AutodriveAI/Autonomous-Mobile-Robot-/Robot Design Files/GamePadDongleHolder.stl

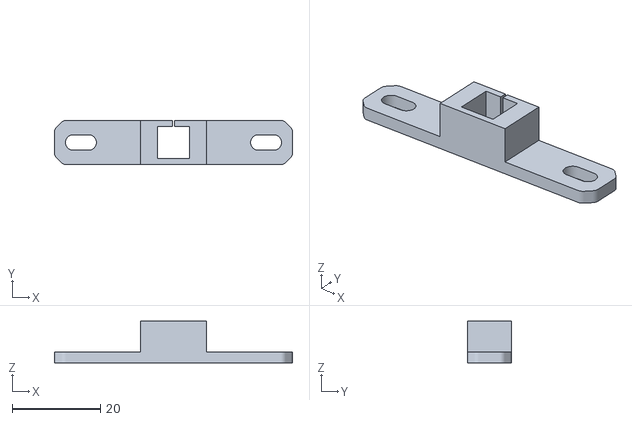
[picture p1: CAD file, 2026-10-15]
Robot Design Files/GamePadDongleHolder.stl
54.0 x 10.0 x 9.50
