AutodriveAI/Autonomous-Mobile-Robot-/ros2_ws/src/amr_description/meshes/Gear_Motor__1__Cut_Extrude8_1_.obj

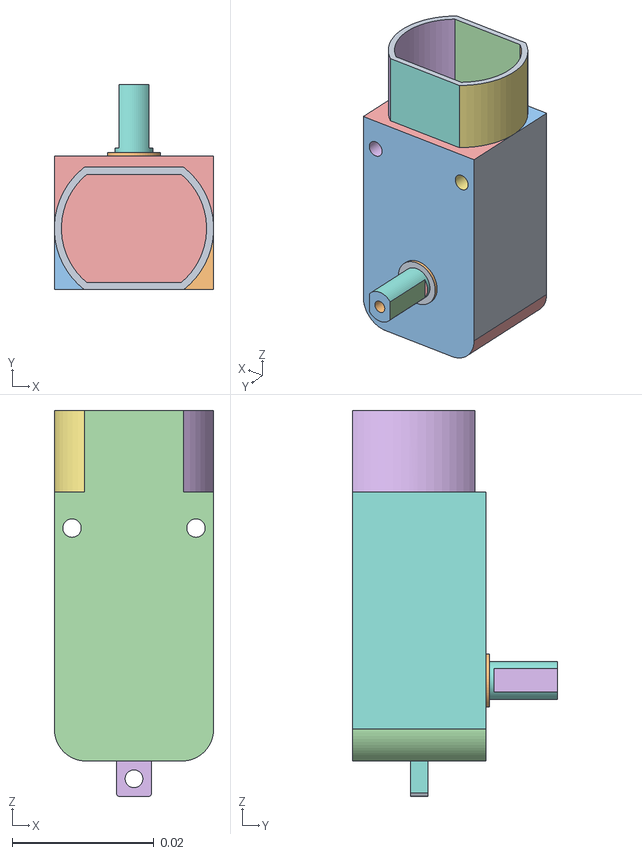
[picture p2: CAD file, 2026-07-27]
ros2_ws/src/amr_description/meshes/Gear_Motor__1__Cut_Extrude8_1_.obj
0.0225 x 0.029 x 0.0545
