AutodriveAI/Autonomous-Mobile-Robot-/Robot Design Files/antenna mount.stl

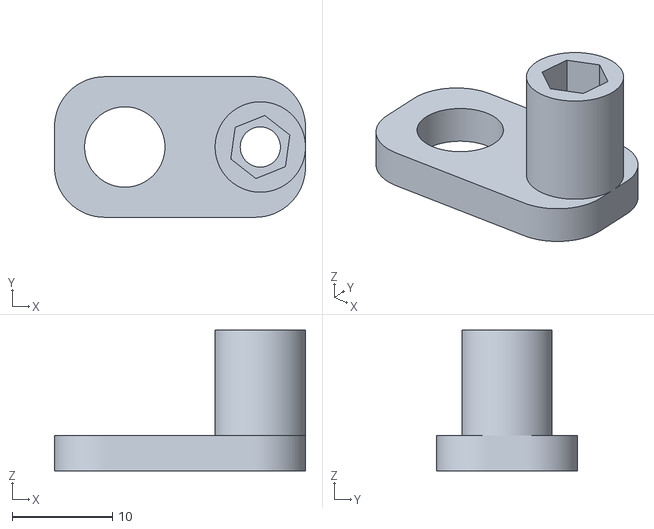
[picture p3: CAD file, 2026-08-02]
Robot Design Files/antenna mount.stl
25.0 x 14.0 x 14.0
