AutodriveAI/Autonomous-Mobile-Robot-/Robot Design Files/Hex Spacer.step

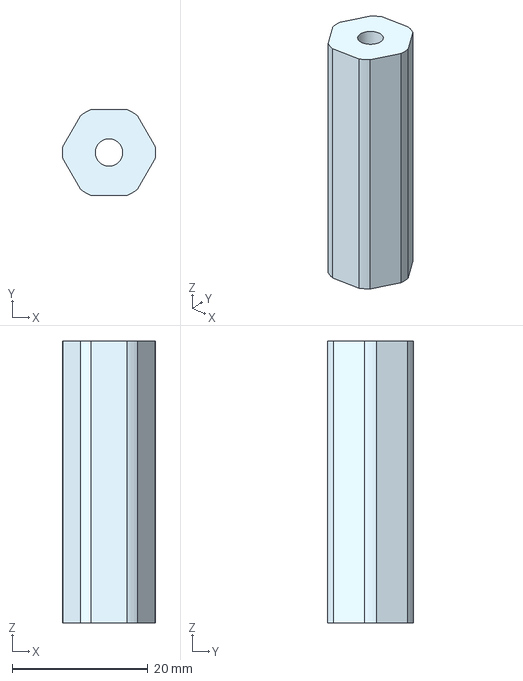
[picture p5: CAD file, 2026-08-02]
Robot Design Files/Hex Spacer.step
13.7 x 12.7 x 41.6 mm
