AutodriveAI/Autonomous-Mobile-Robot-/Robot Design Files/WiFi Antenna.STEP

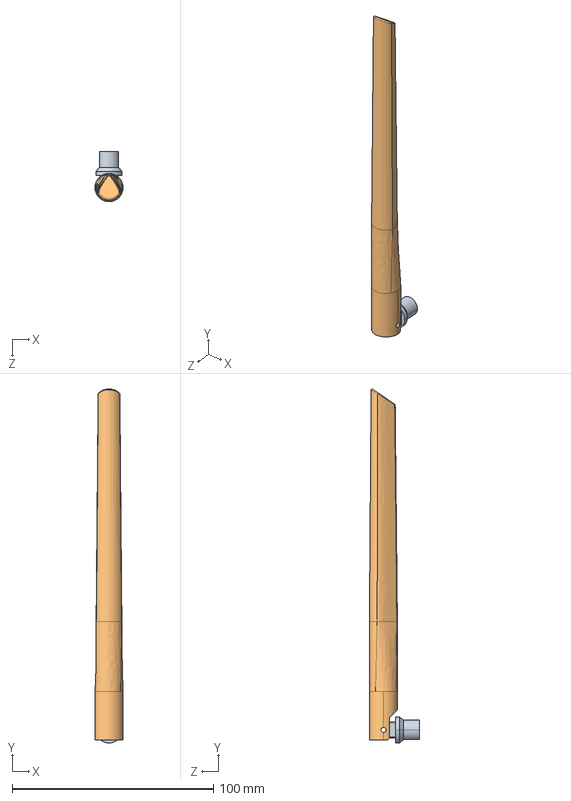
[picture p7: CAD file, 2026-08-02]
Robot Design Files/WiFi Antenna.STEP
14.0 x 176.1 x 25.1 mm
WiFi Antenna 2
WiFi Antenna
