AutodriveAI/Autonomous-Mobile-Robot-/ros2_ws/src/amr_description/meshes/Jetson_1__Body1_1_.obj

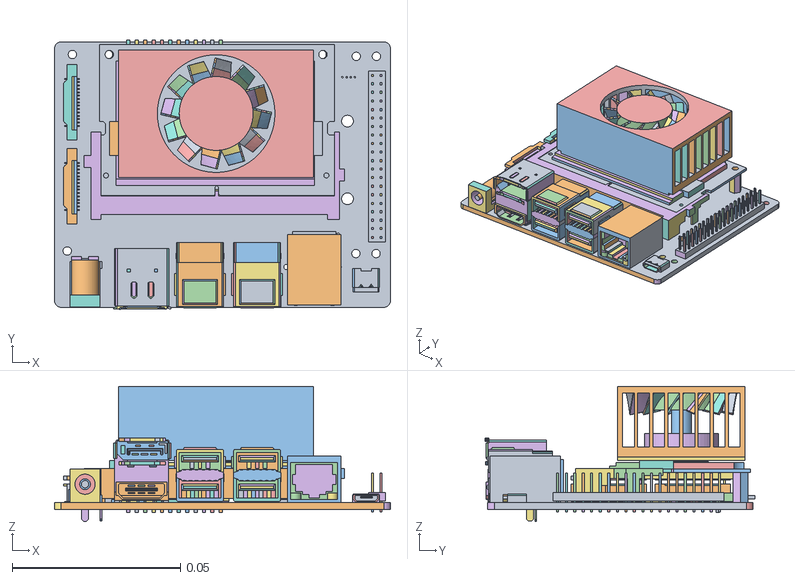
[picture p8: CAD file, 2026-07-27]
ros2_ws/src/amr_description/meshes/Jetson_1__Body1_1_.obj
0.1 x 0.0802 x 0.0402
