AutodriveAI/Autonomous-Mobile-Robot-/Robot Design Files/65mmPillar.STL

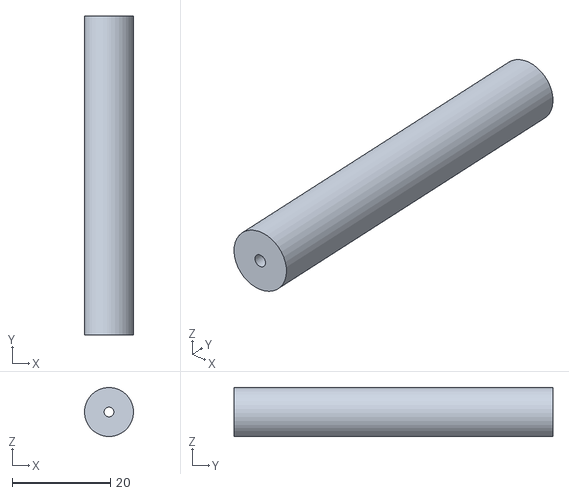
[picture p9: CAD file, 2026-07-25]
Robot Design Files/65mmPillar.STL
9.99 x 65.0 x 10.0
