AutodriveAI/Autonomous-Mobile-Robot-/ros2_ws/src/amr_description/meshes/Default__12_STEP_1_Part22_STEP_1_solid1.obj

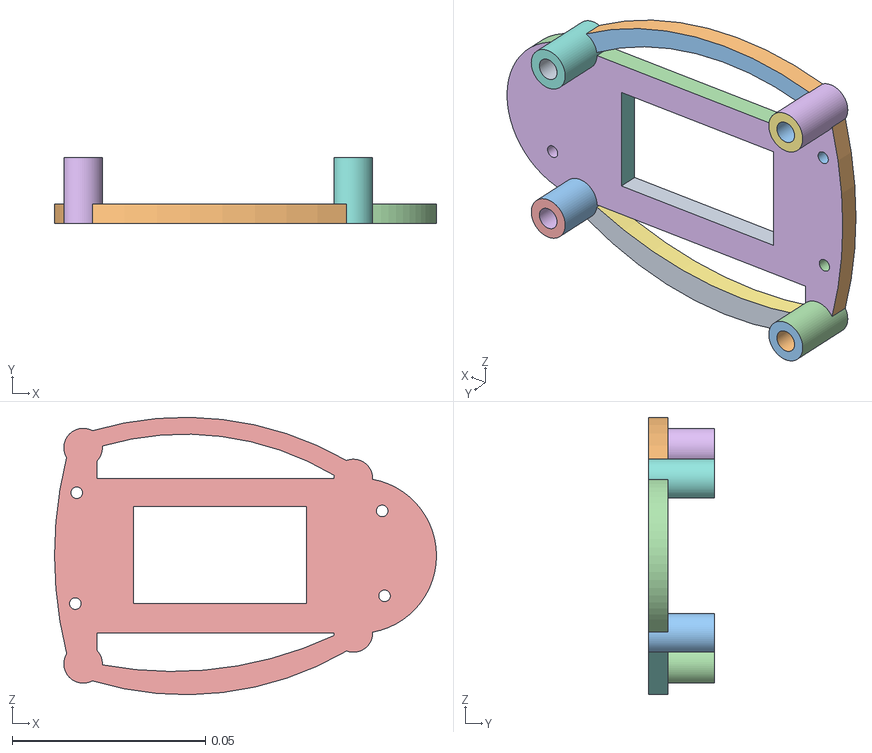
[picture p11: CAD file, 2026-07-27]
ros2_ws/src/amr_description/meshes/Default__12_STEP_1_Part22_STEP_1_solid1.obj
0.0989 x 0.017 x 0.0718
