AutodriveAI/Autonomous-Mobile-Robot-/ros2_ws/src/amr_description/meshes/Default__12_STEP_1_RP_lidar_A1_igs_STEP_1_head_base_igs_STEP_1_solid1.obj

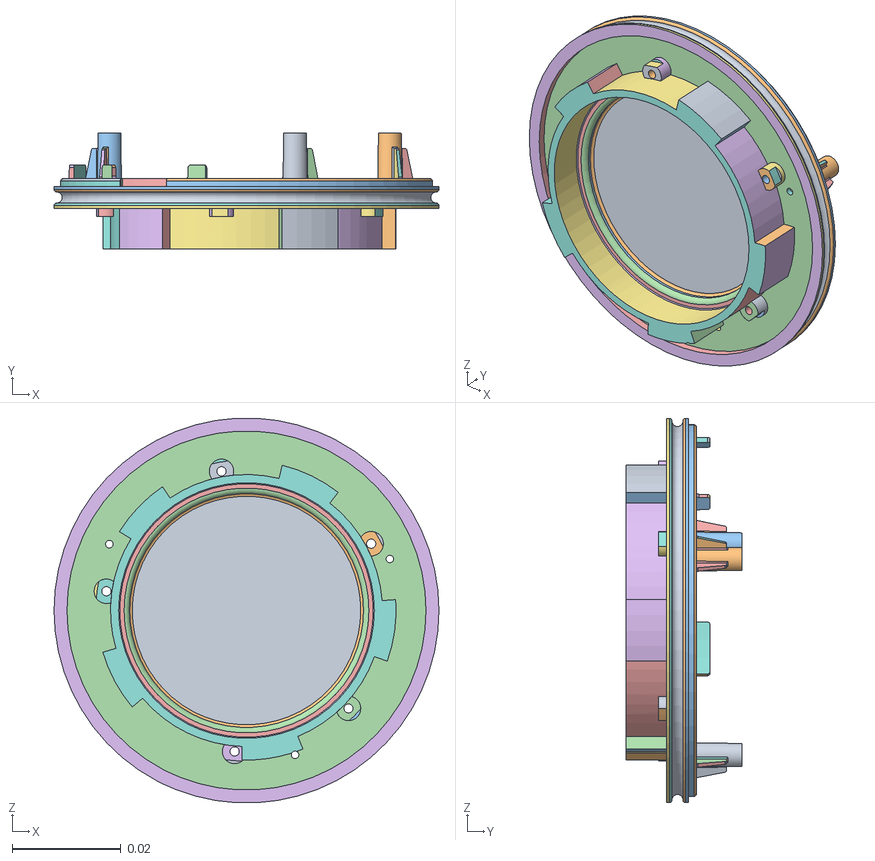
[picture p12: CAD file, 2026-07-27]
ros2_ws/src/amr_description/meshes/Default__12_STEP_1_RP_lidar_A1_igs_STEP_1_head_base_igs_STEP_1_solid1.obj
0.0708 x 0.0214 x 0.0707
