AutodriveAI/Autonomous-Mobile-Robot-/ros2_ws/src/amr_description/meshes/Default__12_STEP_1_RP_lidar_A1_igs_STEP_1_bottom_lid_igs_STEP_1_solid1.obj

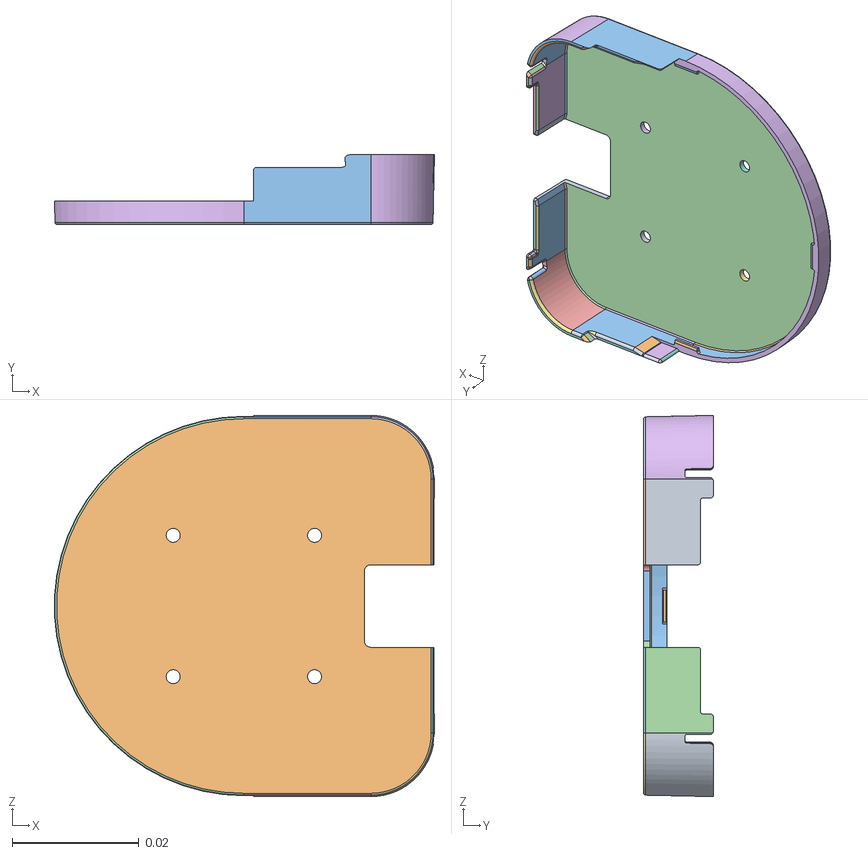
[picture p13: CAD file, 2026-07-27]
ros2_ws/src/amr_description/meshes/Default__12_STEP_1_RP_lidar_A1_igs_STEP_1_bottom_lid_igs_STEP_1_solid1.obj
0.0599 x 0.011 x 0.0601
