AutodriveAI/Autonomous-Mobile-Robot-/ros2_ws/src/amr_description/meshes/Default__12_STEP_1_RP_lidar_A1_igs_STEP_1_stand_8x2_igs_STEP_2_solid1.obj

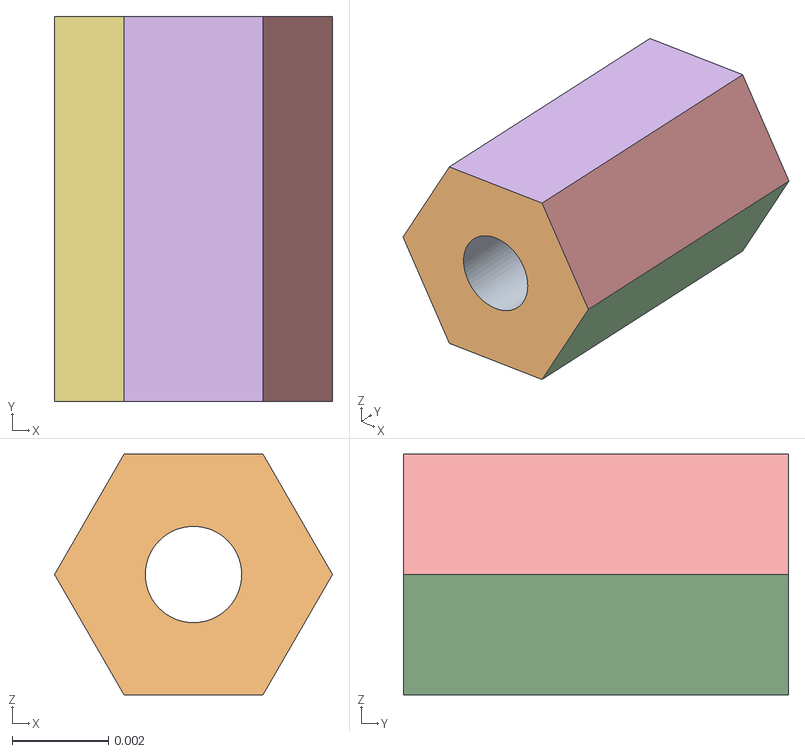
[picture p14: CAD file, 2026-07-27]
ros2_ws/src/amr_description/meshes/Default__12_STEP_1_RP_lidar_A1_igs_STEP_1_stand_8x2_igs_STEP_2_solid1.obj
0.00577 x 0.008 x 0.005
