AutodriveAI/Autonomous-Mobile-Robot-/ros2_ws/src/amr_description/meshes/Default__12_STEP_1_RP_lidar_A1_igs_STEP_1_stand_15x2_igs_STEP_4_solid1.obj

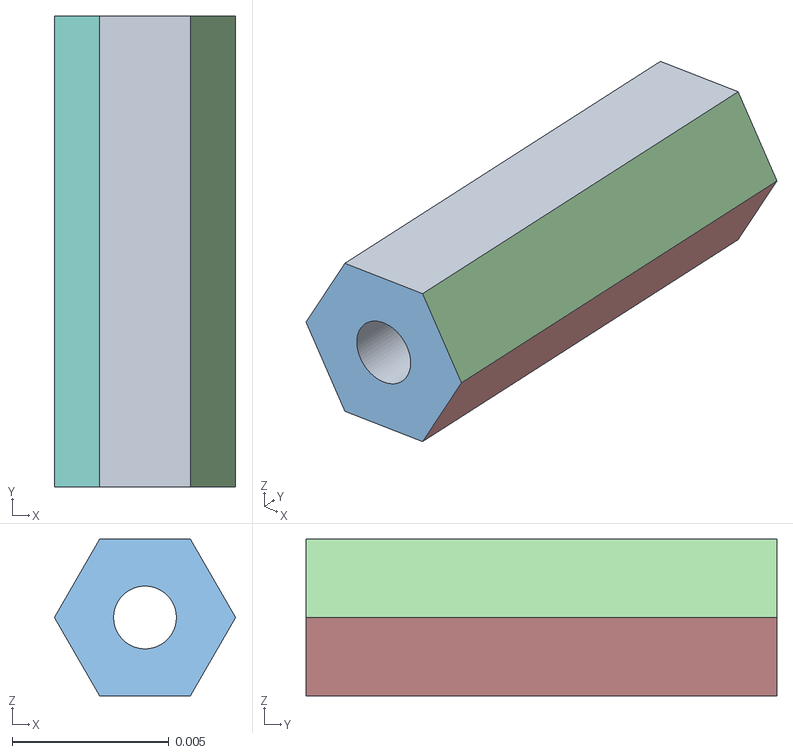
[picture p16: CAD file, 2026-07-27]
ros2_ws/src/amr_description/meshes/Default__12_STEP_1_RP_lidar_A1_igs_STEP_1_stand_15x2_igs_STEP_4_solid1.obj
0.00577 x 0.015 x 0.005
