AutodriveAI/Autonomous-Mobile-Robot-/ros2_ws/src/amr_description/meshes/Default__Ball_Caster_12mm_stp_1___03_________stp_1_solid1.obj

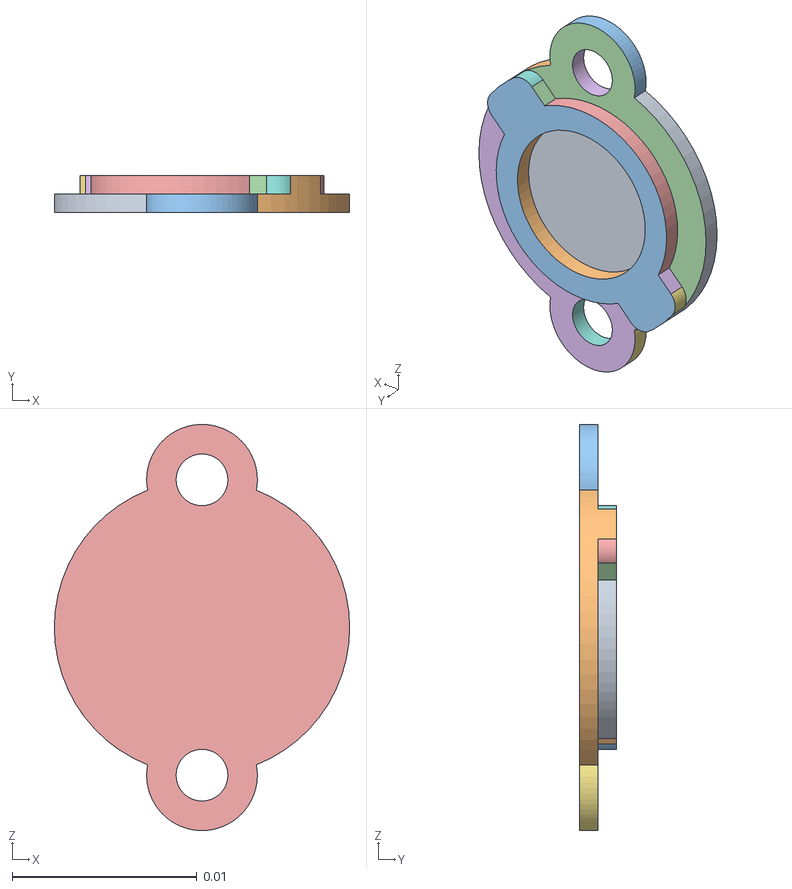
[picture p17: CAD file, 2026-07-27]
ros2_ws/src/amr_description/meshes/Default__Ball_Caster_12mm_stp_1___03_________stp_1_solid1.obj
0.016 x 0.002 x 0.022
