AutodriveAI/Autonomous-Mobile-Robot-/ros2_ws/src/amr_description/meshes/Default__Ball_Caster_12mm_stp_1___01_______12_stp_1_solid1.obj

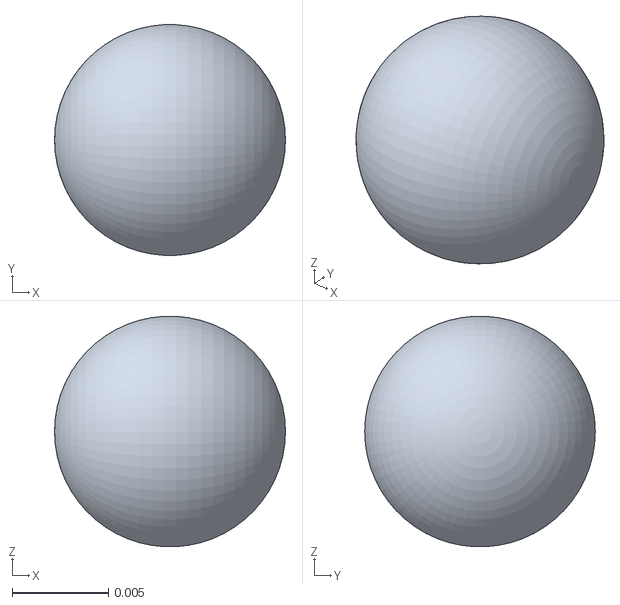
[picture p18: CAD file, 2026-07-27]
ros2_ws/src/amr_description/meshes/Default__Ball_Caster_12mm_stp_1___01_______12_stp_1_solid1.obj
0.012 x 0.012 x 0.012
