AutodriveAI/Autonomous-Mobile-Robot-/ros2_ws/src/amr_description/meshes/Part_1_2.obj

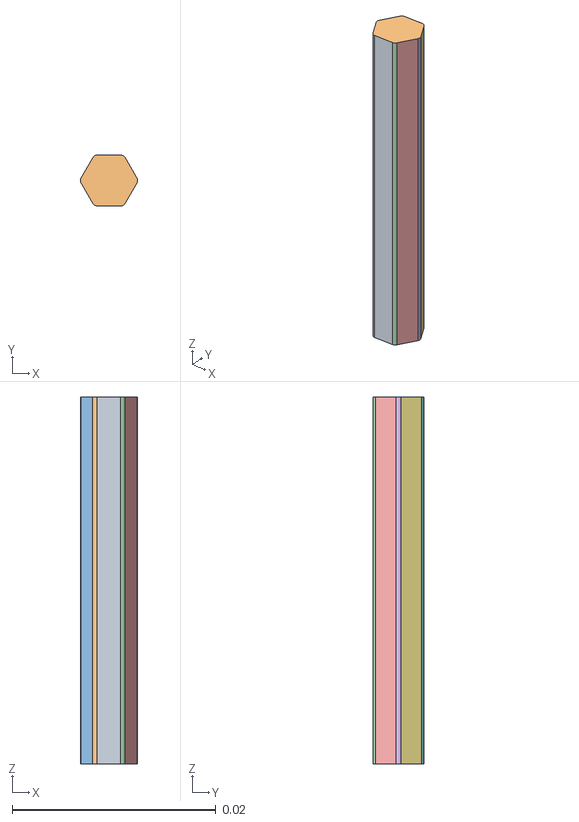
[picture p19: CAD file, 2026-07-27]
ros2_ws/src/amr_description/meshes/Part_1_2.obj
0.00562 x 0.00501 x 0.036
