AutodriveAI/Autonomous-Mobile-Robot-/ros2_ws/src/amr_description/meshes/Default__12_STEP_1_RP_lidar_A1_igs_STEP_1_laser_igs_STEP_1_solid1.obj

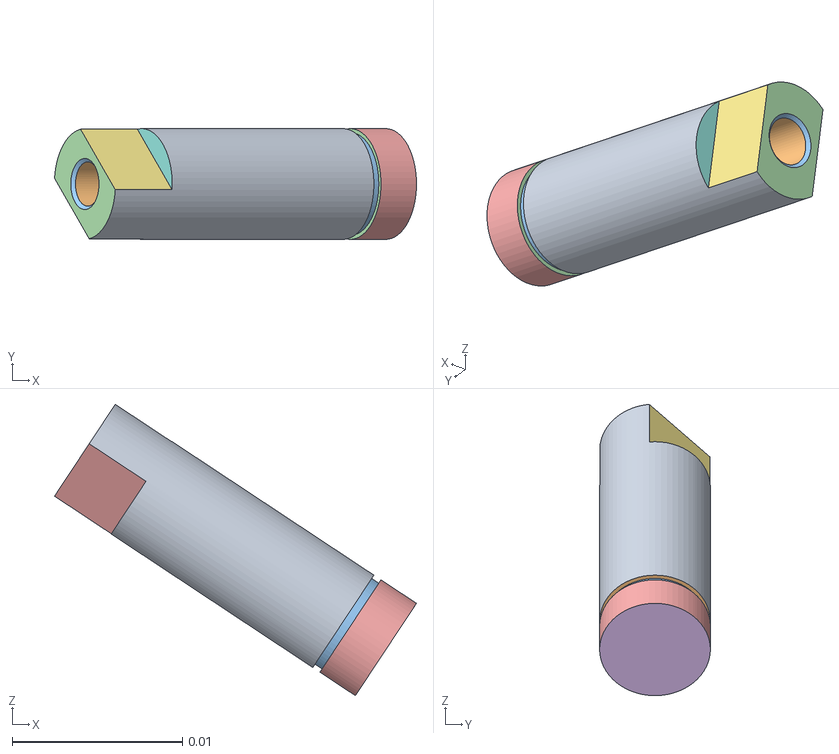
[picture p20: CAD file, 2026-07-27]
ros2_ws/src/amr_description/meshes/Default__12_STEP_1_RP_lidar_A1_igs_STEP_1_laser_igs_STEP_1_solid1.obj
0.0213 x 0.00649 x 0.0171
