AutodriveAI/Autonomous-Mobile-Robot-/ros2_ws/src/amr_description/meshes/Gear_Motor__1__Split1_2__1_.obj

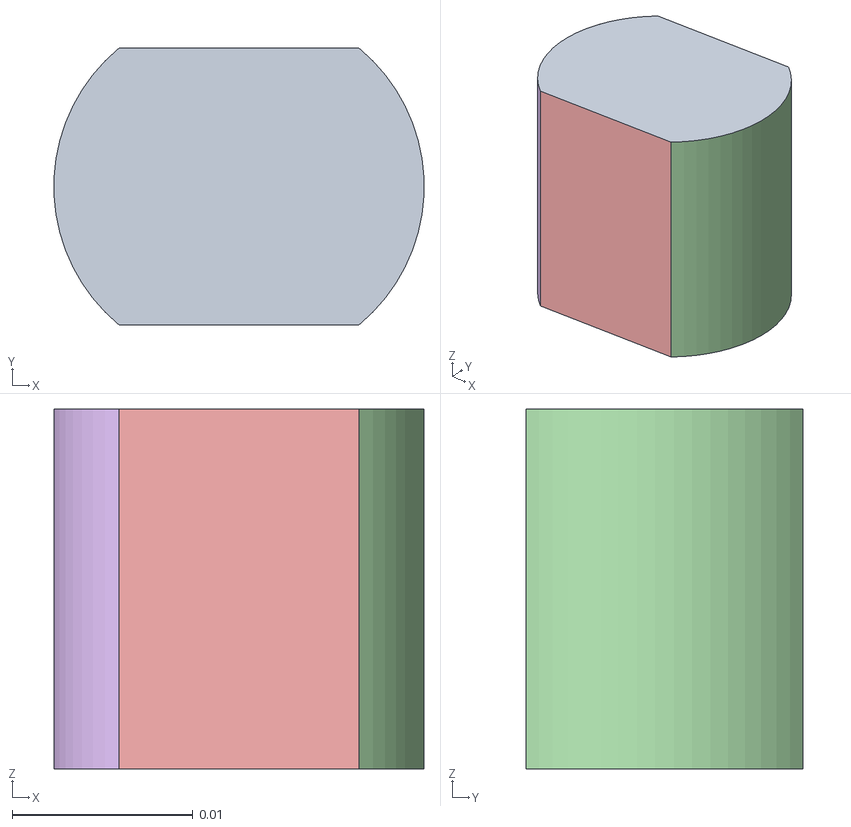
[picture p21: CAD file, 2026-07-27]
ros2_ws/src/amr_description/meshes/Gear_Motor__1__Split1_2__1_.obj
0.0205 x 0.0153 x 0.0199
