AutodriveAI/Autonomous-Mobile-Robot-/ros2_ws/src/amr_description/meshes/Default__12_STEP_1_RP_lidar_A1_igs_STEP_1_base_igs_STEP_1_solid1.obj

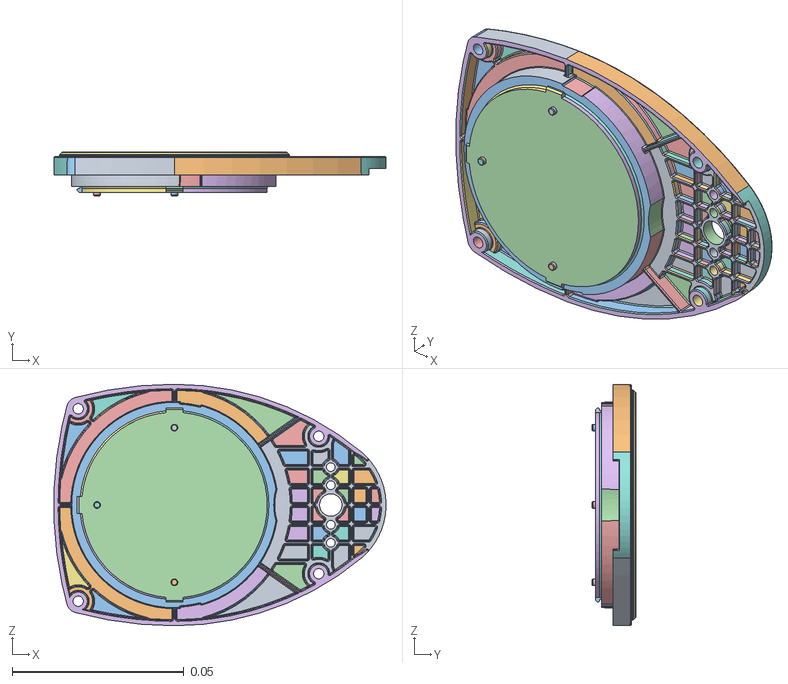
[picture p22: CAD file, 2026-07-27]
ros2_ws/src/amr_description/meshes/Default__12_STEP_1_RP_lidar_A1_igs_STEP_1_base_igs_STEP_1_solid1.obj
0.0966 x 0.0127 x 0.0703
