AutodriveAI/Autonomous-Mobile-Robot-/ros2_ws/src/amr_description/meshes/Default__Ball_Caster_12mm_stp_1___02_______4_stp_4_solid1.obj

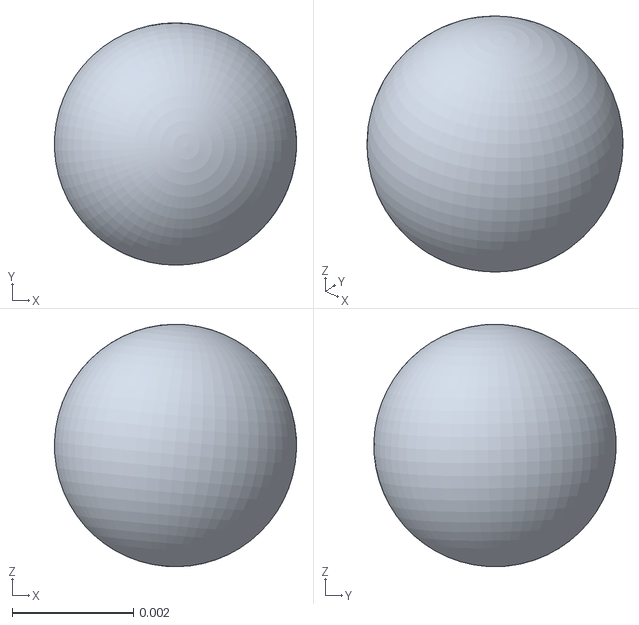
[picture p23: CAD file, 2026-07-27]
ros2_ws/src/amr_description/meshes/Default__Ball_Caster_12mm_stp_1___02_______4_stp_4_solid1.obj
0.00399 x 0.004 x 0.004
