AutodriveAI/Autonomous-Mobile-Robot-/ros2_ws/src/amr_description/meshes/motor_stand___1.obj

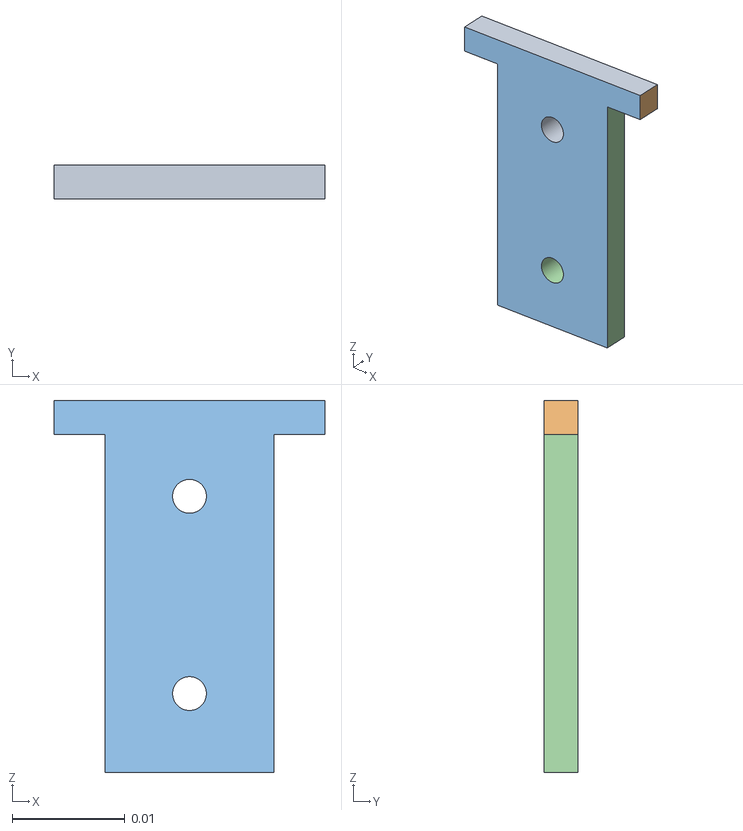
[picture p25: CAD file, 2026-07-27]
ros2_ws/src/amr_description/meshes/motor_stand___1.obj
0.024 x 0.003 x 0.033
