AutodriveAI/Autonomous-Mobile-Robot-/ros2_ws/src/amr_description/meshes/WiFi_Antenna_2__Cut_Extrude1.obj

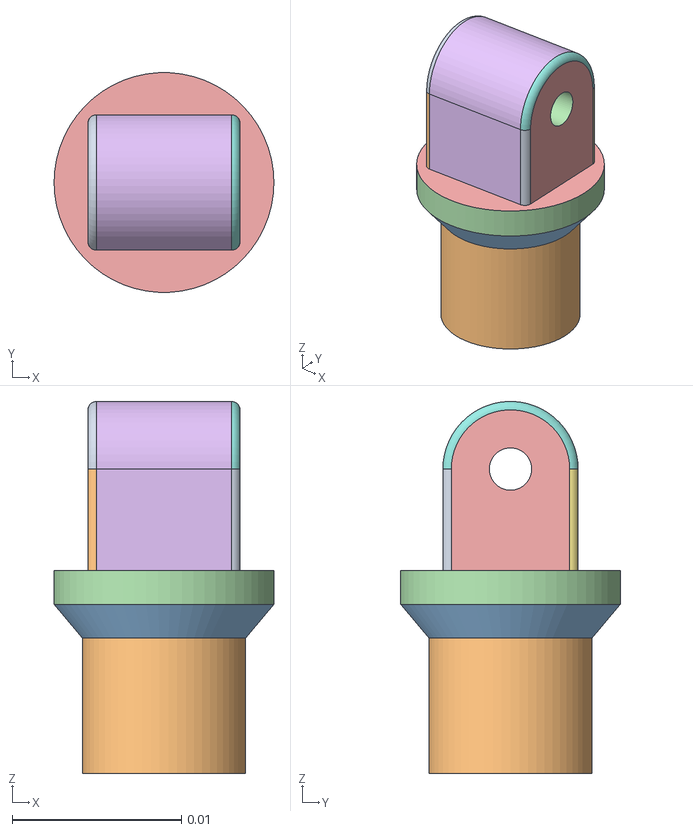
[picture p26: CAD file, 2026-07-27]
ros2_ws/src/amr_description/meshes/WiFi_Antenna_2__Cut_Extrude1.obj
0.013 x 0.013 x 0.022
