AutodriveAI/Autonomous-Mobile-Robot-/ros2_ws/src/amr_description/meshes/mid_floor_1.obj

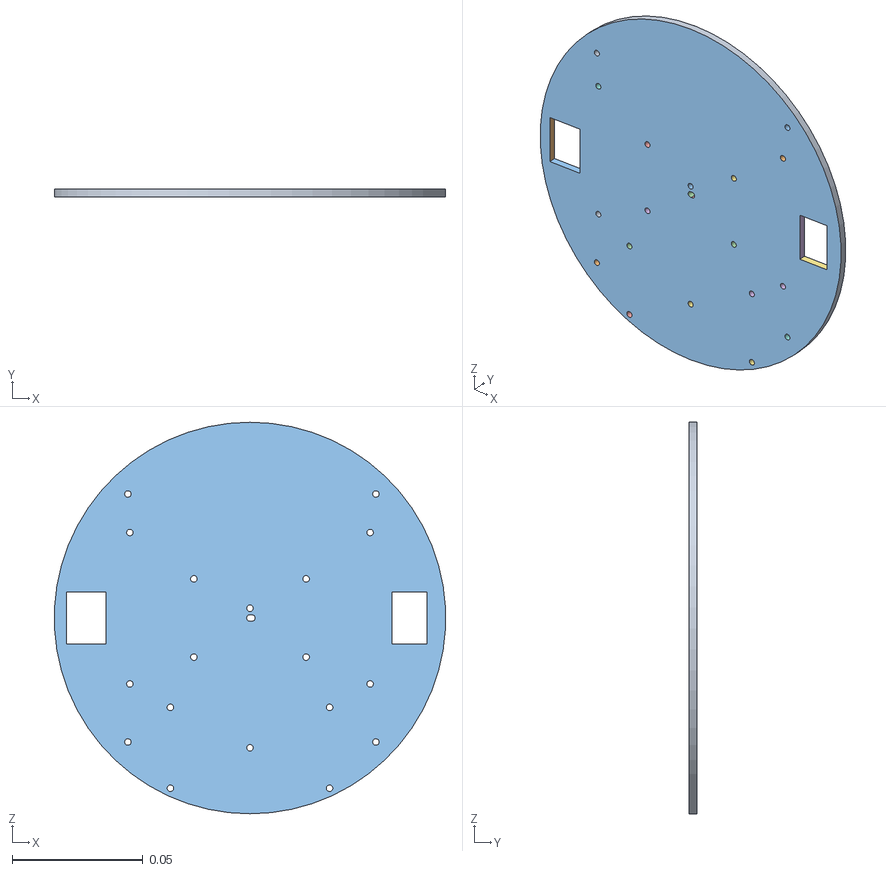
[picture p27: CAD file, 2026-07-27]
ros2_ws/src/amr_description/meshes/mid_floor_1.obj
0.15 x 0.003 x 0.15
