AutodriveAI/Autonomous-Mobile-Robot-/ros2_ws/src/amr_description/meshes/Part_1_1.obj

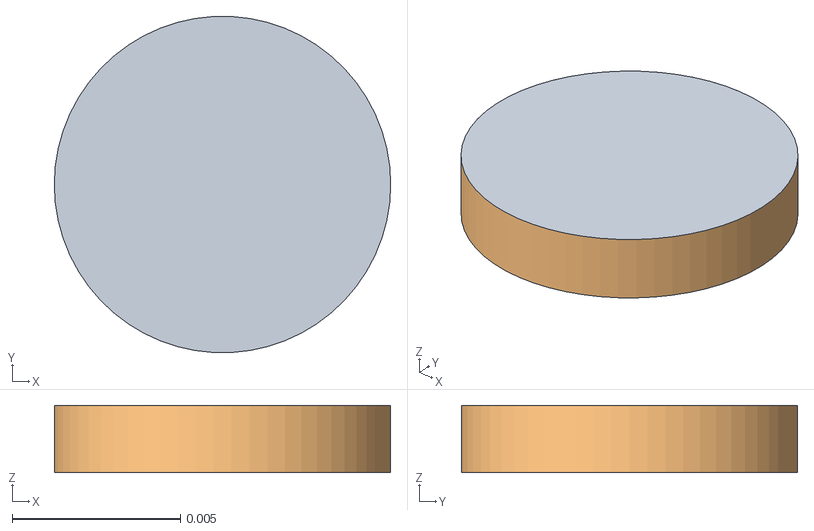
[picture p29: CAD file, 2026-07-27]
ros2_ws/src/amr_description/meshes/Part_1_1.obj
0.01 x 0.00999 x 0.002
