AutodriveAI/Autonomous-Mobile-Robot-/ros2_ws/src/amr_description/meshes/WiFi_Antenna__Fillet3.obj

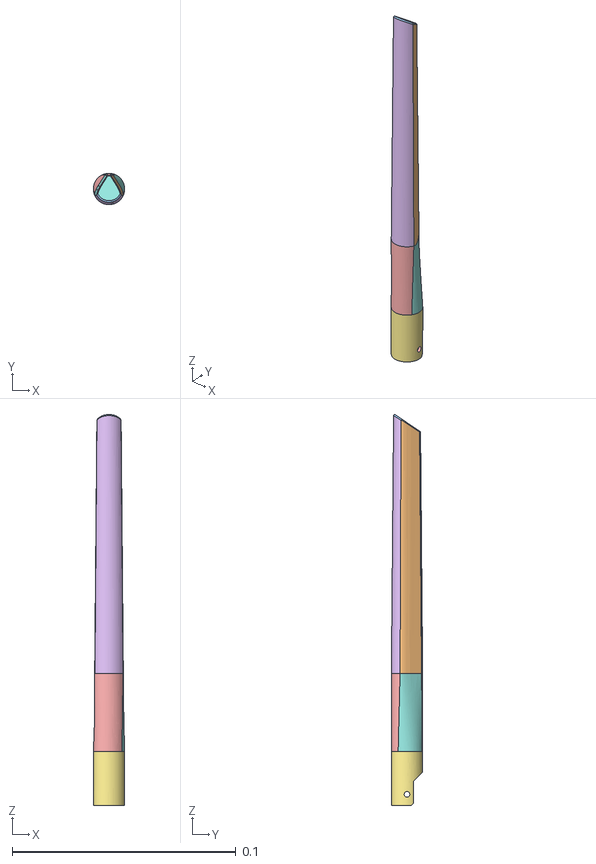
[picture p30: CAD file, 2026-07-27]
ros2_ws/src/amr_description/meshes/WiFi_Antenna__Fillet3.obj
0.014 x 0.014 x 0.175
