AutodriveAI/Autonomous-Mobile-Robot-/ros2_ws/src/amr_description/meshes/bottom_layer_1.obj

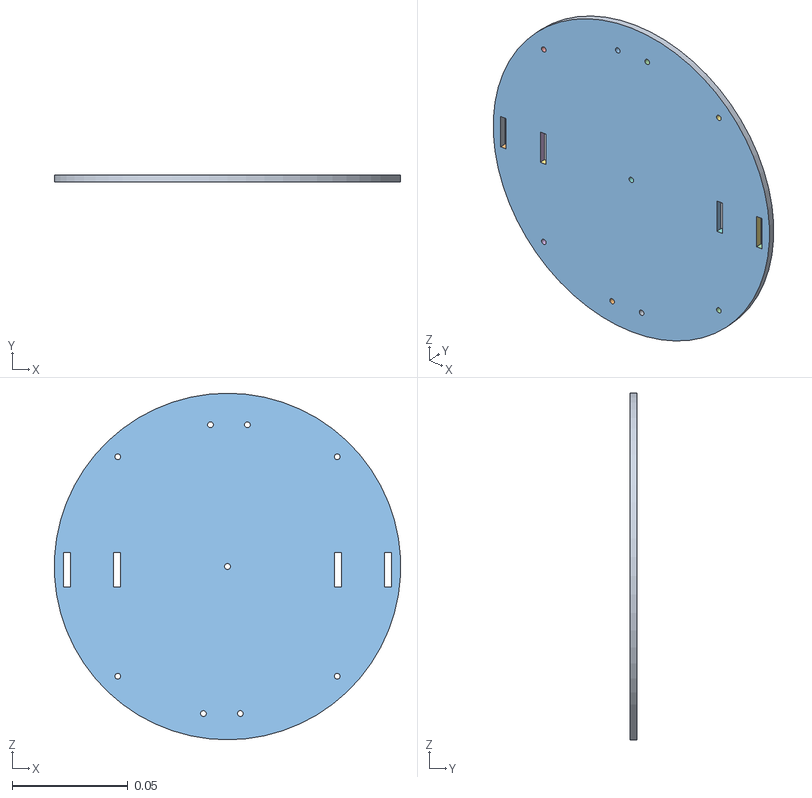
[picture p31: CAD file, 2026-07-27]
ros2_ws/src/amr_description/meshes/bottom_layer_1.obj
0.15 x 0.003 x 0.15
