AutodriveAI/Autonomous-Mobile-Robot-/ros2_ws/src/amr_description/meshes/Part_1.obj

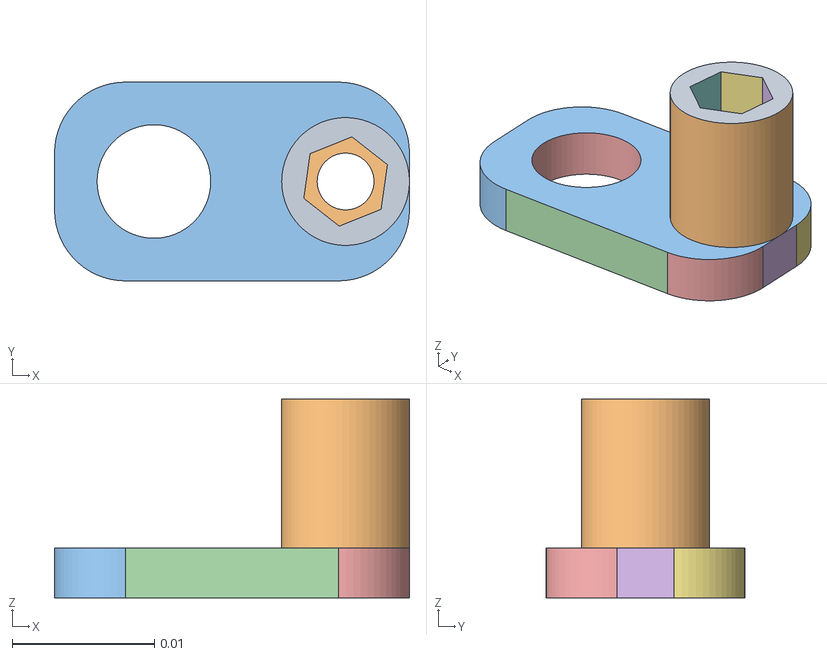
[picture p32: CAD file, 2026-07-27]
ros2_ws/src/amr_description/meshes/Part_1.obj
0.025 x 0.014 x 0.014
