AutodriveAI/Autonomous-Mobile-Robot-/ros2_ws/src/amr_description/meshes/pillar_1.obj

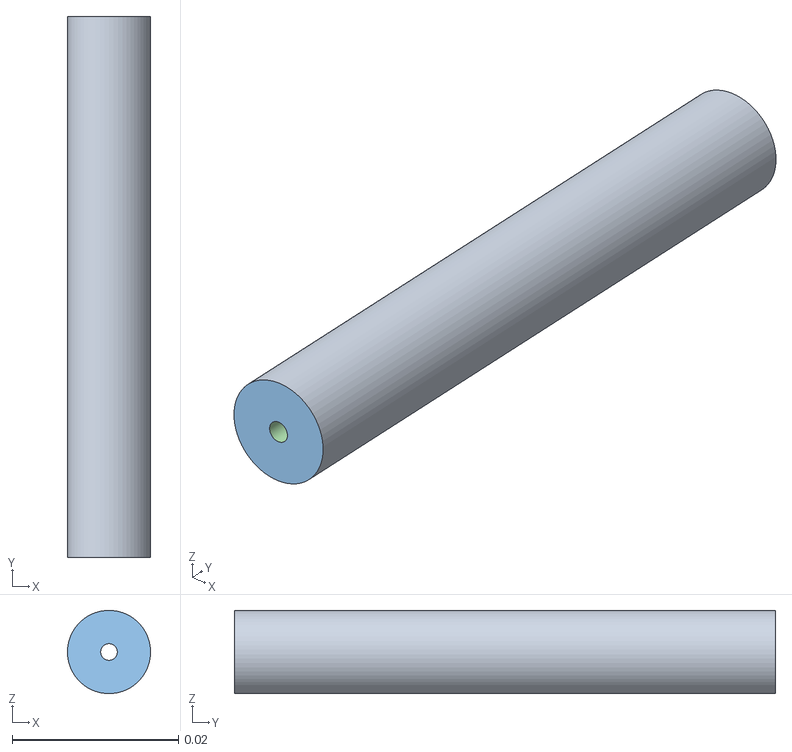
[picture p33: CAD file, 2026-07-27]
ros2_ws/src/amr_description/meshes/pillar_1.obj
0.00999 x 0.065 x 0.01
