AutodriveAI/Autonomous-Mobile-Robot-/ros2_ws/src/amr_description/meshes/final_layer_1.obj

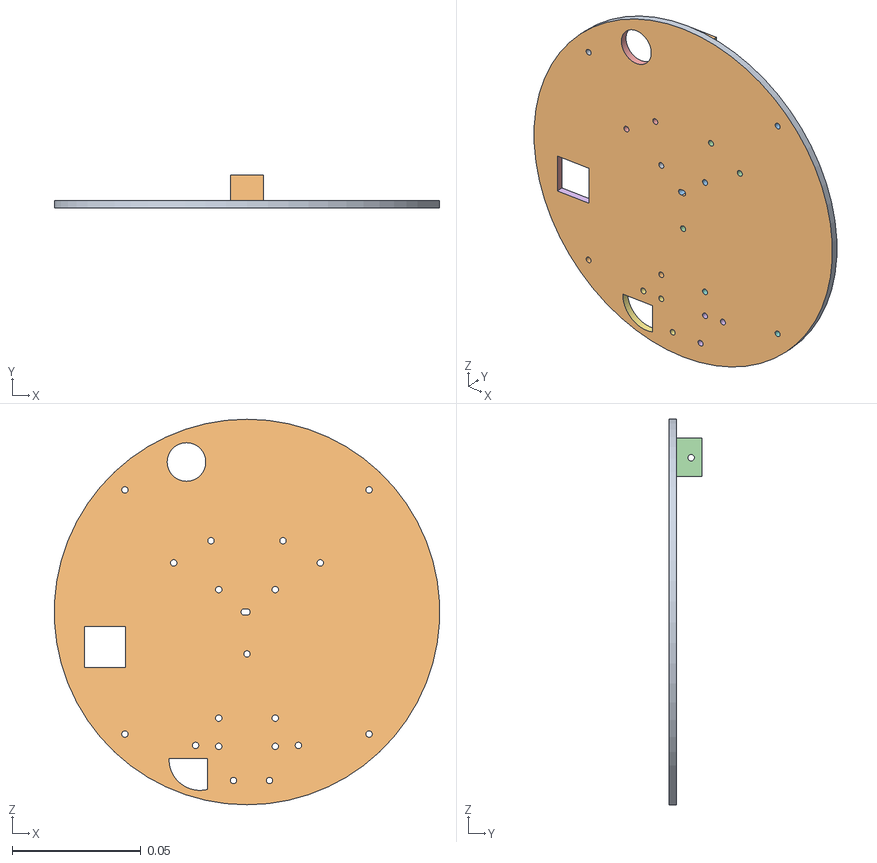
[picture p34: CAD file, 2026-07-27]
ros2_ws/src/amr_description/meshes/final_layer_1.obj
0.15 x 0.013 x 0.15
