AutodriveAI/Autonomous-Mobile-Robot-/ros2_ws/src/amr_description/meshes/Gear_Motor__1__Fillet5_1_.obj

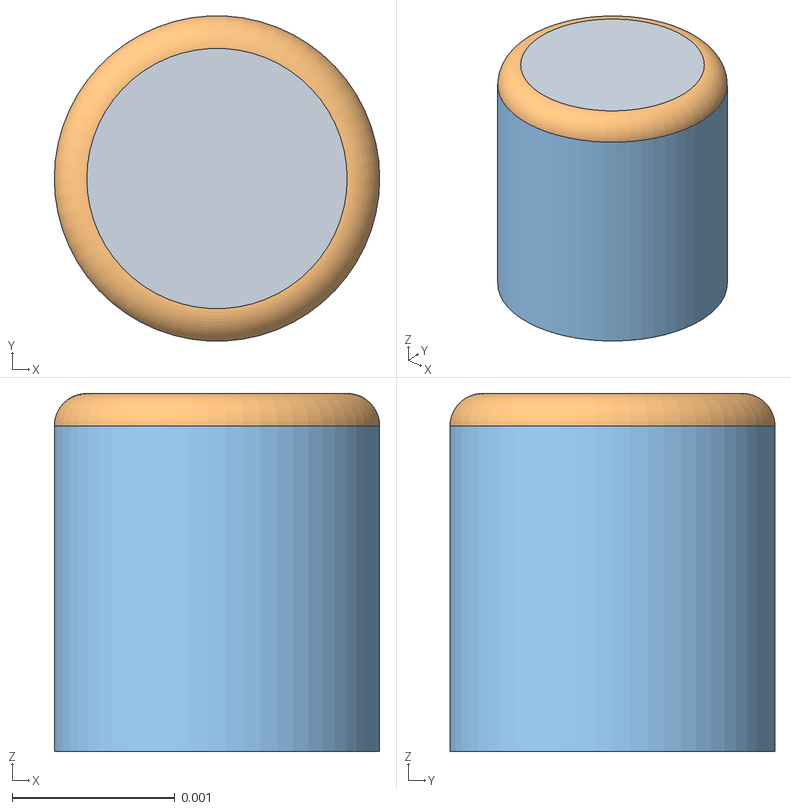
[picture p36: CAD file, 2026-07-27]
ros2_ws/src/amr_description/meshes/Gear_Motor__1__Fillet5_1_.obj
0.002 x 0.002 x 0.0022
