AutodriveAI/Autonomous-Mobile-Robot-/ros2_ws/src/amr_description/meshes/Default__12_STEP_1_RP_lidar_A1_igs_STEP_1_wheel_igs_STEP_1_solid1.obj

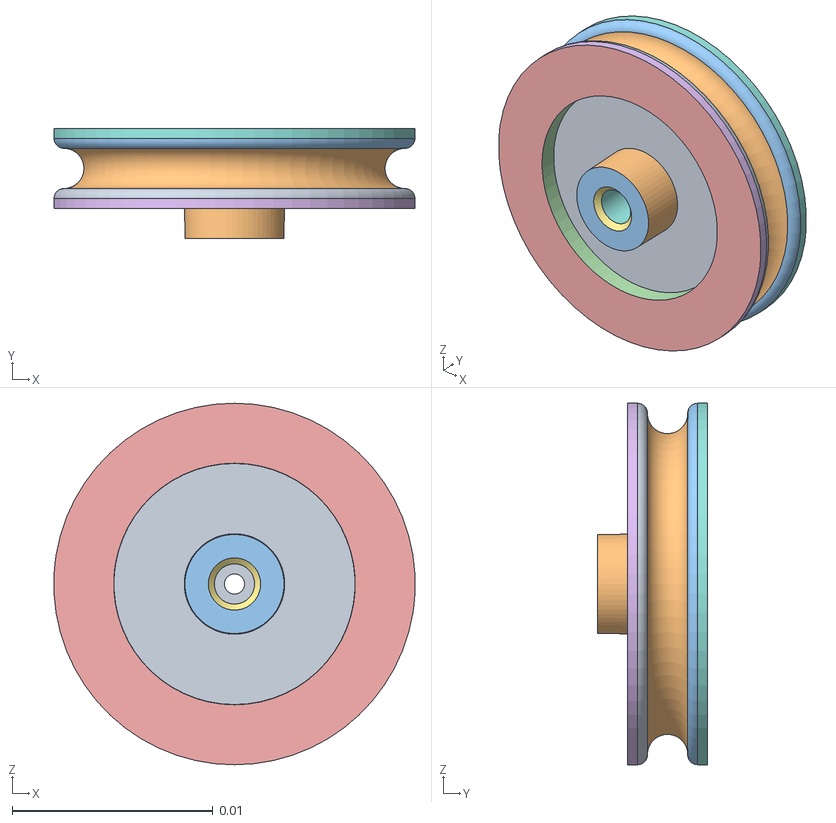
[picture p37: CAD file, 2026-07-27]
ros2_ws/src/amr_description/meshes/Default__12_STEP_1_RP_lidar_A1_igs_STEP_1_wheel_igs_STEP_1_solid1.obj
0.018 x 0.0055 x 0.018
