AutodriveAI/Autonomous-Mobile-Robot-/ros2_ws/src/amr_description/meshes/Default__12_STEP_1_RP_lidar_A1_igs_STEP_1_devboard_igs_STEP_1_solid1.obj

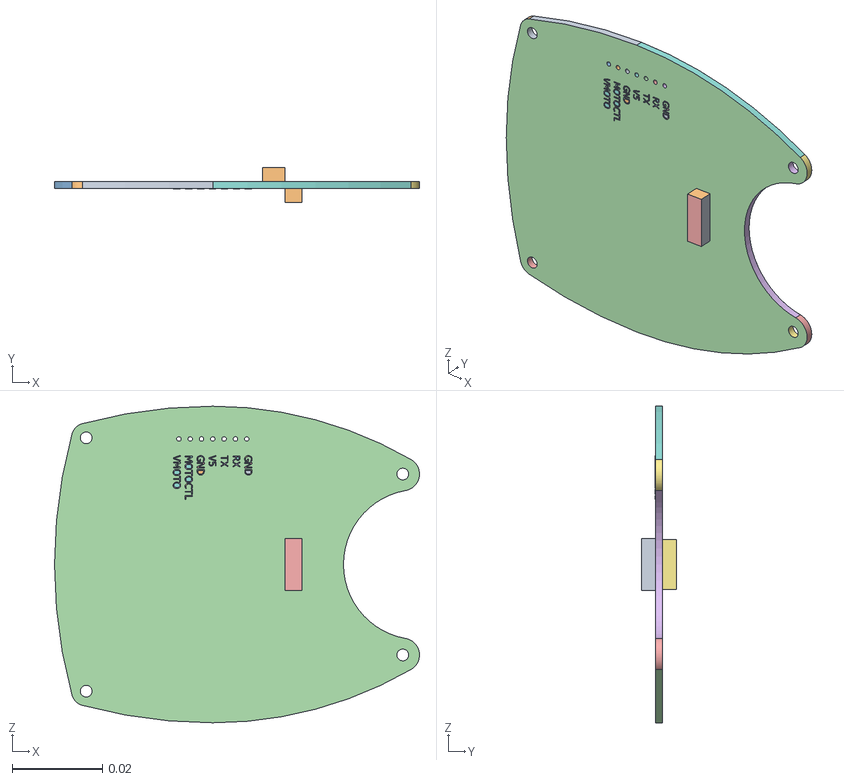
[picture p38: CAD file, 2026-07-27]
ros2_ws/src/amr_description/meshes/Default__12_STEP_1_RP_lidar_A1_igs_STEP_1_devboard_igs_STEP_1_solid1.obj
0.0807 x 0.00764 x 0.07
