AutodriveAI/Autonomous-Mobile-Robot-/ros2_ws/src/amr_description/meshes/wheel_of_robo_1__Rim_1_.obj

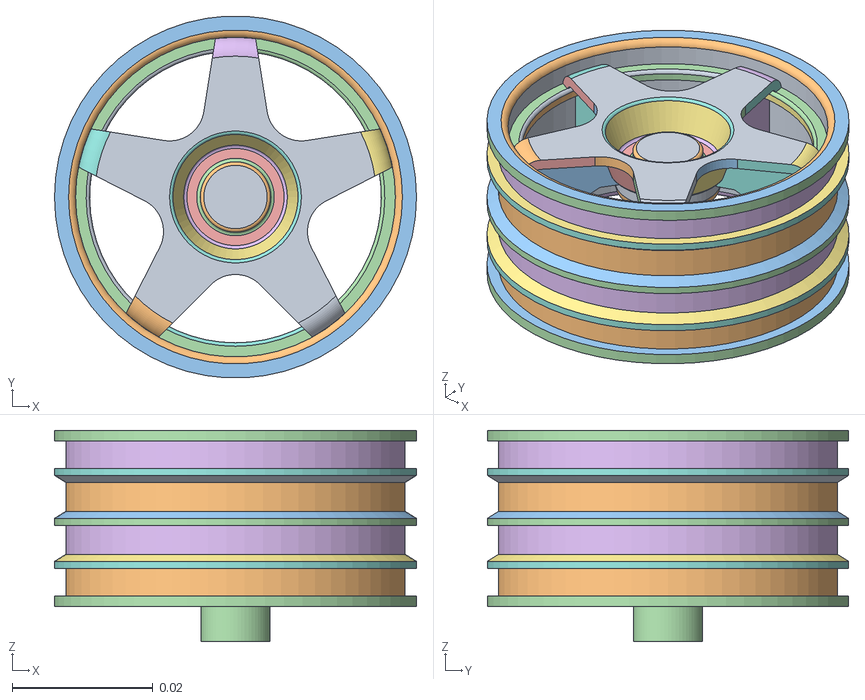
[picture p39: CAD file, 2026-07-27]
ros2_ws/src/amr_description/meshes/wheel_of_robo_1__Rim_1_.obj
0.0514 x 0.0513 x 0.03
