AutodriveAI/Autonomous-Mobile-Robot-/ros2_ws/src/amr_description/meshes/wheel_of_robo_1__Tyre_1_.obj

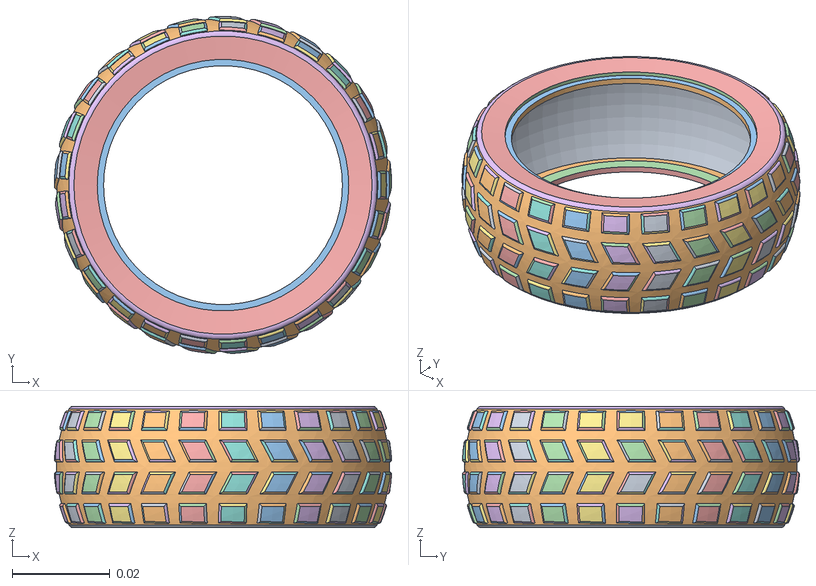
[picture p41: CAD file, 2026-07-27]
ros2_ws/src/amr_description/meshes/wheel_of_robo_1__Tyre_1_.obj
0.0689 x 0.0689 x 0.0248
