AutodriveAI/Autonomous-Mobile-Robot-/ros2_ws/src/amr_description/meshes/Default__12_STEP_1_RP_lidar_A1_igs_STEP_1_rubber_igs_STEP_1_solid1.obj

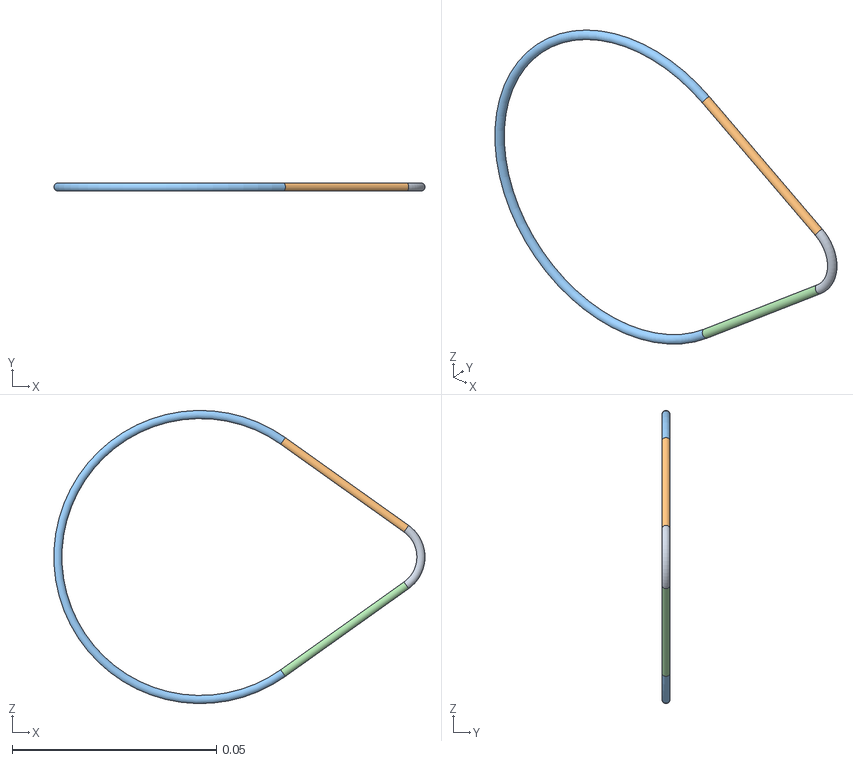
[picture p43: CAD file, 2026-07-27]
ros2_ws/src/amr_description/meshes/Default__12_STEP_1_RP_lidar_A1_igs_STEP_1_rubber_igs_STEP_1_solid1.obj
0.0908 x 0.002 x 0.0718
