AutodriveAI/Autonomous-Mobile-Robot-/ros2_ws/src/amr_description/meshes/IMU.obj

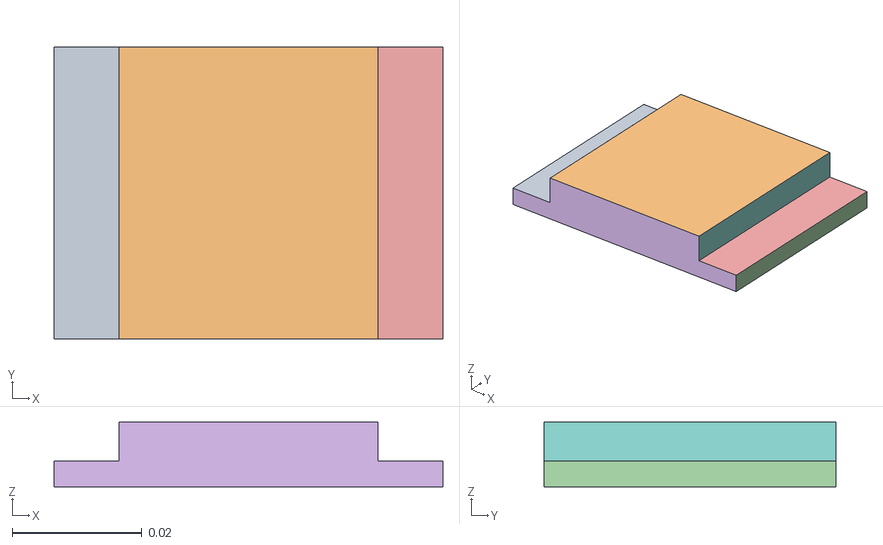
[picture p45: CAD file, 2026-07-27]
ros2_ws/src/amr_description/meshes/IMU.obj
0.06 x 0.045 x 0.01
