AutodriveAI/Autonomous-Mobile-Robot-/(list of files, cad)

Other CAD files:
Robot Design Files/Electronic parts/STM32 Nucleo'.step
ros2_ws/src/amr_description/meshes/Default__12_STEP_1_RP_lidar_A1_igs_STEP_1_stand_15x2_igs_STEP_2_solid1.obj
ros2_ws/src/amr_description/meshes/Default__12_STEP_1_RP_lidar_A1_igs_STEP_1_stand_8x2_igs_STEP_4_solid1.obj
ros2_ws/src/amr_description/meshes/Default__12_STEP_1_RP_lidar_A1_igs_STEP_1_stand_8x2_igs_STEP_1_solid1.obj
ros2_ws/src/amr_description/meshes/Default__Ball_Caster_12mm_stp_1___02_______4_stp_2_solid1.obj
ros2_ws/src/amr_description/meshes/Default__12_STEP_1_RP_lidar_A1_igs_STEP_1_stand_8x2_igs_STEP_3_solid1.obj
ros2_ws/src/amr_description/meshes/Default__12_STEP_1_RP_lidar_A1_igs_STEP_1_stand_15x2_igs_STEP_3_solid1.obj
ros2_ws/src/amr_description/meshes/Default__Ball_Caster_12mm_stp_1___02_______4_stp_3_solid1.obj
ros2_ws/src/amr_description/meshes/Default__12_STEP_1_RP_lidar_A1_igs_STEP_1_stand_15x2_igs_STEP_1_solid1.obj
ros2_ws/src/amr_description/meshes/Default__Ball_Caster_12mm_stp_1___02_______4_stp_1_solid1.obj
ros2_ws/src/amr_description/meshes/Default__12_STEP_1_RP_lidar_A1_igs_STEP_1_Woodscrews_GB_TYPE136_M2X6_N_igs_STEP_1_solid1.obj
ros2_ws/src/amr_description/meshes/Default__12_STEP_1_RP_lidar_A1_igs_STEP_1_Woodscrews_GB_TYPE136_M2X6_N_igs_STEP_2_solid1.obj
ros2_ws/src/amr_description/meshes/Default__12_STEP_1_RP_lidar_A1_igs_STEP_1_Woodscrews_GB_TYPE136_M2X6_N_igs_STEP_3_solid1.obj
ros2_ws/src/amr_description/meshes/Default__12_STEP_1_RP_lidar_A1_igs_STEP_1_Woodscrews_GB_TYPE136_M2X6_N_igs_STEP_4_solid1.obj
ros2_ws/src/amr_description/meshes/Default__12_STEP_1_RP_lidar_A1_igs_STEP_1_Woodscrews_GB_TYPE136_M2X6_N_igs_STEP_5_solid1.obj
