AutodriveAI/Autonomous-Mobile-Robot-/ros2_ws/src/amr_description/urdf/robot_core.xacro

<?xml version='1.0' encoding='utf-8'?>
<robot xmlns:xacro="http://www.ros.org/wiki/xacro">
  <!--
    Core AMR robot description.

    This file intentionally contains only the physical robot model:
      - links,
      - joints,
      - visual meshes,
      - simple collision geometry,
      - inertial approximations.

    Simulation plugins live in gazebo.xacro.
    ros2_control interfaces live in ros2_control.xacro.
    The top-level robot.urdf.xacro includes this file and decides which extras
    are attached for RViz, Gazebo, or real-hardware experiments.
  -->

  <xacro:property name="body_collision_radius" value="0.10" />
  <xacro:property name="body_collision_height" value="0.13" />
  <xacro:property name="body_collision_center_z" value="0.085" />
  <xacro:property name="body_inertial_height" value="0.21" />
  <xacro:property name="wheel_collision_radius" value="0.035" />
  <xacro:property name="wheel_collision_width" value="0.04" />
  <xacro:property name="antenna_collision_radius" value="0.02" />
  <xacro:property name="antenna_collision_height" value="0.21" />

  <!-- Inertia of a rectangular box centered on the link frame. -->
  <xacro:macro name="box_inertial" params="mass x y z">
    <inertial>
      <origin xyz="0 0 0" rpy="0 0 0" />
      <mass value="${mass}" />
      <inertia ixx="${mass * (y*y + z*z) / 12.0}" ixy="0" ixz="0" iyy="${mass * (x*x + z*z) / 12.0}" iyz="0" izz="${mass * (x*x + y*y) / 12.0}" />
    </inertial>
  </xacro:macro>

  <!-- Inertia of a wheel-like cylinder whose rotation axle is along the link's Y axis. -->
  <xacro:macro name="wheel_inertial" params="mass radius width">
    <inertial>
      <origin xyz="0 0 0" rpy="0 0 0" />
      <mass value="${mass}" />
      <inertia ixx="${mass * (3.0*radius*radius + width*width) / 12.0}" ixy="0" ixz="0" iyy="${mass * radius*radius / 2.0}" iyz="0" izz="${mass * (3.0*radius*radius + width*width) / 12.0}" />
    </inertial>
  </xacro:macro>

  <!-- Inertia of a small ball caster approximation. -->
  <xacro:macro name="sphere_inertial" params="mass radius">
    <inertial>
      <origin xyz="0 0 0" rpy="0 0 0" />
      <mass value="${mass}" />
      <inertia ixx="${2.0 * mass * radius*radius / 5.0}" ixy="0" ixz="0" iyy="${2.0 * mass * radius*radius / 5.0}" iyz="0" izz="${2.0 * mass * radius*radius / 5.0}" />
    </inertial>
  </xacro:macro>

  <!-- Inertia of a vertical cylinder whose cylinder axis is along the link's Z axis. -->
  <xacro:macro name="vertical_cylinder_inertial" params="mass radius height xyz">
    <inertial>
      <origin xyz="${xyz}" rpy="0 0 0" />
      <mass value="${mass}" />
      <inertia ixx="${mass * (3.0*radius*radius + height*height) / 12.0}" ixy="0" ixz="0" iyy="${mass * (3.0*radius*radius + height*height) / 12.0}" iyz="0" izz="${mass * radius*radius / 2.0}" />
    </inertial>
  </xacro:macro>

  <xacro:macro name="amr_robot_core">
  <link name="base_link" />
  <link name="chassis_link">
    <xacro:vertical_cylinder_inertial mass="2.5" radius="${body_collision_radius}" height="${body_inertial_height}" xyz="0.025 0 0.0906" />
    <collision>
      <origin xyz="0.025 0 ${body_collision_center_z}" rpy="0 0 0" />
      <geometry>
        <cylinder radius="${body_collision_radius}" length="${body_collision_height}" />
      </geometry>
    </collision>
    <visual>
      <origin xyz="0.02288 0 -0.01425" rpy="1.57079633 -0 1.57079633" />
      <geometry>
        <mesh filename="package://amr_description/meshes/bottom_layer_1.obj" scale="1 1 1" />
      </geometry>
      <material name="0.894118_0.894118_0.894118_0.000000_0.000000">
        <color rgba="0.894118 0.894118 0.894118 1" />
      </material>
    </visual>
    <visual>
      <origin xyz="0.0426386 -0.0997946 0.0911878" rpy="1.57079633 4.8965888e-12 -3.14158898" />
      <geometry>
        <mesh filename="package://amr_description/meshes/Default__12_STEP_1_Part22_STEP_1_solid1.obj" scale="1 1 1" />
      </geometry>
      <material name="0.792157_0.819608_0.933333_0.000000_0.000000">
        <color rgba="0.792157 0.819608 0.933333 1" />
      </material>
    </visual>
    <visual>
      <origin xyz="0.02288 3.26081522e-24 0.12175" rpy="1.57079633 7.17465e-41 1.57079633" />
      <geometry>
        <mesh filename="package://amr_description/meshes/final_layer_1.obj" scale="1 1 1" />
      </geometry>
      <material name="0.894118_0.894118_0.894118_0.000000_0.000000">
        <color rgba="0.894118 0.894118 0.894118 1" />
      </material>
    </visual>
    <!-- Disabled floating Gear Motor CAD visual blocks.
        <visual>
          <origin xyz="1.17413105 0.830189451 -0.655320351" rpy="-1.57079633 2.65360929e-06 -1.57079102" />
          <geometry>
            <mesh filename="package://amr_description/meshes/Gear_Motor__1__Cut_Extrude7_1_.obj" scale="1 1 1" />
          </geometry>
          <material name="0.101961_0.101961_0.101961_0.000000_0.000000">
            <color rgba="0.101961 0.101961 0.101961 1" />
          </material>
        </visual>
        <visual>
          <origin xyz="1.17413105 0.830189451 -0.655320351" rpy="-1.57079633 2.65360929e-06 -1.57079102" />
          <geometry>
            <mesh filename="package://amr_description/meshes/Gear_Motor__1__Split1_2__1_.obj" scale="1 1 1" />
          </geometry>
          <material name="1.000000_0.949020_0.909804_0.000000_0.000000">
            <texture />
            <color rgba="1 0.94902 0.909804 1" />
          </material>
        </visual>
        <visual>
          <origin xyz="1.17413105 0.830189451 -0.655320351" rpy="-1.57079633 2.65360929e-06 -1.57079102" />
          <geometry>
            <mesh filename="package://amr_description/meshes/Gear_Motor__1__Fillet5_1_.obj" scale="1 1 1" />
          </geometry>
          <material name="0.776471_0.756863_0.737255_0.000000_0.000000">
            <texture />
            <color rgba="0.776471 0.756863 0.737255 1" />
          </material>
        </visual>
        <visual>
          <origin xyz="1.1741351 -0.830180778 0.538370165" rpy="-1.57079633 7.34641021e-06 -1.57079633" />
          <geometry>
            <mesh filename="package://amr_description/meshes/Gear_Motor__1__Split1_2__1_.obj" scale="1 1 1" />
          </geometry>
          <material name="1.000000_0.949020_0.909804_0.000000_0.000000">
            <color rgba="1 0.94902 0.909804 1" />
          </material>
        </visual>
        <visual>
          <origin xyz="1.1741351 -0.830180778 0.538370165" rpy="-1.57079633 7.34641021e-06 -1.57079633" />
          <geometry>
            <mesh filename="package://amr_description/meshes/Gear_Motor__1__Fillet5_1_.obj" scale="1 1 1" />
          </geometry>
          <material name="0.776471_0.756863_0.737255_0.000000_0.000000">
            <texture />
            <color rgba="0.776471 0.756863 0.737255 1" />
          </material>
        </visual>
        <visual>
          <origin xyz="1.1741351 -0.830180778 0.538370165" rpy="-1.57079633 7.34641021e-06 -1.57079633" />
          <geometry>
            <mesh filename="package://amr_description/meshes/Gear_Motor__1__Cut_Extrude7_1_.obj" scale="1 1 1" />
          </geometry>
          <material name="0.101961_0.101961_0.101961_0.000000_0.000000">
            <texture />
            <color rgba="0.101961 0.101961 0.101961 1" />
          </material>
        </visual>
    -->
    <visual>
      <origin xyz="0.00760011021 -0.058476 -1.39368818e-07" rpy="2.51540947 -1.57079179 0.62618318" />
      <geometry>
        <mesh filename="package://amr_description/meshes/Gear_Motor__1__Cut_Extrude8_1_.obj" scale="1 1 1" />
      </geometry>
      <material name="1.000000_1.000000_0.000000_0.000000_0.000000">
        <color rgba="1 1 0 1" />
      </material>
    </visual>
    <visual>
      <origin xyz="0.0076 0.058477 0" rpy="-1.57079499 1.57079265 -1.57079499" />
      <geometry>
        <mesh filename="package://amr_description/meshes/Gear_Motor__1__Cut_Extrude8_1_.obj" scale="1 1 1" />
      </geometry>
      <material name="1.000000_1.000000_0.000000_0.000000_0.000000">
        <color rgba="1 1 0 1" />
      </material>
    </visual>
    <visual>
      <origin xyz="0.01138 -0.000257321 0.049" rpy="3.67321e-06 -2.65358979e-06 -1.57079633" />
      <geometry>
        <mesh filename="package://amr_description/meshes/Jetson_1__Body1_1_.obj" scale="1 1 1" />
      </geometry>
      <material name="0.878431_0.870588_0.870588_0.000000_0.000000">
        <color rgba="0.878431 0.870588 0.870588 1" />
      </material>
    </visual>
    <visual>
      <origin xyz="0.02288 -0.000757321 0.05375" rpy="1.57079633 3.065e-43 1.57079633" />
      <geometry>
        <mesh filename="package://amr_description/meshes/mid_floor_1.obj" scale="1 1 1" />
      </geometry>
      <material name="0.894118_0.894118_0.894118_0.000000_0.000000">
        <color rgba="0.894118 0.894118 0.894118 1" />
      </material>
    </visual>
    <visual>
      <origin xyz="0.0214951 0.0679272685 -0.0186543243" rpy="3.14158633 -3.67320021e-06 -3.14159265" />
      <geometry>
        <mesh filename="package://amr_description/meshes/motor_stand___1.obj" scale="1 1 1" />
      </geometry>
      <material name="0.894118_0.894118_0.894118_0.000000_0.000000">
        <color rgba="0.894118 0.894118 0.894118 1" />
      </material>
    </visual>
    <visual>
      <origin xyz="0.0214953485 -0.0709269005 -0.0186548753" rpy="-3.14158735 3.67321975e-06 3.14158898" />
      <geometry>
        <mesh filename="package://amr_description/meshes/motor_stand___1.obj" scale="1 1 1" />
      </geometry>
      <material name="0.894118_0.894118_0.894118_0.000000_0.000000">
        <color rgba="0.894118 0.894118 0.894118 1" />
      </material>
    </visual>
    <visual>
      <origin xyz="0.0214951 -0.0494267315 -0.0186550668" rpy="3.14158633 -3.67320021e-06 -3.14159265" />
      <geometry>
        <mesh filename="package://amr_description/meshes/motor_stand___1.obj" scale="1 1 1" />
      </geometry>
      <material name="0.894118_0.894118_0.894118_0.000000_0.000000">
        <color rgba="0.894118 0.894118 0.894118 1" />
      </material>
    </visual>
    <visual>
      <origin xyz="0.0214951 0.0494272685 -0.0186544413" rpy="-3.14158633 3.67318342e-06 2.65360814e-06" />
      <geometry>
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
      <geometry>
        <mesh filename="package://amr_description/meshes/pillar_1.obj" scale="1 1 1" />
      </geometry>
      <material name="0.894118_0.894118_0.894118_0.000000_0.000000">
        <color rgba="0.894118 0.894118 0.894118 1" />
      </material>
    </visual>
    <visual>
      <origin xyz="0.05038 -0.061500021 0.05675" rpy="1.57079633 2.77279e-42 1.57079633" />
      <geometry>
        <mesh filename="package://amr_description/meshes/pillar_1.obj" scale="1 1 1" />
      </geometry>
      <material name="0.894118_0.894118_0.894118_0.000000_0.000000">
        <color rgba="0.894118 0.894118 0.894118 1" />
      </material>
    </visual>
    <visual>
      <origin xyz="-0.02462 -0.0475 -0.01125" rpy="1.57079633 6.13e-43 1.57079633" />
      <geometry>
        <mesh filename="package://amr_description/meshes/pillar_1.obj" scale="1 1 1" />
      </geometry>
      <material name="0.894118_0.894118_0.894118_0.000000_0.000000">
        <color rgba="0.894118 0.894118 0.894118 1" />
      </material>
    </visual>
    <visual>
      <origin xyz="0.05038 0.0615 0.05675" rpy="1.57079633 1.63582e-40 1.57079633" />
      <geometry>
        <mesh filename="package://amr_description/meshes/pillar_1.obj" scale="1 1 1" />
      </geometry>
      <material name="0.894118_0.894118_0.894118_0.000000_0.000000">
        <color rgba="0.894118 0.894118 0.894118 1" />
      </material>
    </visual>
  </link>
  <link name="left_wheel_link">
    <xacro:wheel_inertial mass="0.18" radius="${wheel_collision_radius}" width="${wheel_collision_width}" />
    <collision>
      <origin xyz="0 0 0" rpy="1.57079633 0 0" />
      <geometry>
        <cylinder radius="${wheel_collision_radius}" length="${wheel_collision_width}" />
      </geometry>
    </collision>
    <visual>
      <origin xyz="-1.10196153e-07 0.012927 -2.64437736e-07" rpy="-1.57080368 2.20829369e-11 3.6732051e-06" />
      <geometry>
        <mesh filename="package://amr_description/meshes/wheel_of_robo_1__Rim_1_.obj" scale="1 1 1" />
      </geometry>
      <material name="1.000000_1.000000_0.000000_0.000000_0.000000">
        <color rgba="1 1 0 1" />
      </material>
    </visual>
    <visual>
      <origin xyz="-2.11209291e-08 -0.011323 -1.50549789e-07" rpy="1.57079163 2.20829369e-11 3.6732051e-06" />
      <geometry>
        <mesh filename="package://amr_description/meshes/wheel_of_robo_1__Tyre_1_.obj" scale="1 1 1" />
      </geometry>
      <material name="0.227451_0.227451_0.227451_0.000000_0.000000">
        <color rgba="0.227451 0.227451 0.227451 1" />
      </material>
    </visual>
  </link>
  <link name="right_wheel_link">
    <xacro:wheel_inertial mass="0.18" radius="${wheel_collision_radius}" width="${wheel_collision_width}" />
    <collision>
      <origin xyz="0 0 0" rpy="1.57079633 0 0" />
      <geometry>
        <cylinder radius="${wheel_collision_radius}" length="${wheel_collision_width}" />
      </geometry>
    </collision>
    <visual>
      <origin xyz="0 -0.012926 0" rpy="-1.57079367 -0 3.14158898" />
      <geometry>
        <mesh filename="package://amr_description/meshes/wheel_of_robo_1__Rim_1_.obj" scale="1 1 1" />
      </geometry>
      <material name="1.000000_1.000000_0.000000_0.000000_0.000000">
        <color rgba="1 1 0 1" />
      </material>
    </visual>
    <visual>
      <origin xyz="8.90845525e-08 0.011324 -1.28776829e-07" rpy="1.57080164 1.4189239e-31 3.14158898" />
      <geometry>
        <mesh filename="package://amr_description/meshes/wheel_of_robo_1__Tyre_1_.obj" scale="1 1 1" />
      </geometry>
      <material name="0.227451_0.227451_0.227451_0.000000_0.000000">
        <color rgba="0.227451 0.227451 0.227451 1" />
      </material>
    </visual>
  </link>
  <link name="right_caster_link">
    <xacro:sphere_inertial mass="0.05" radius="0.012" />
    <collision>
      <origin xyz="0 0 -0.0045" rpy="0 0 0" />
      <geometry>
        <sphere radius="0.012" />
      </geometry>
    </collision>
    <visual>
      <origin xyz="-0.004 0.001521707 0.000143142857" rpy="-1.57079633 -9.74816658e-12 -1.57079898" />
      <geometry>
        <mesh filename="package://amr_description/meshes/Default__Ball_Caster_12mm_stp_1___01_______12_stp_1_solid1.obj" scale="1 1 1" />
      </geometry>
      <material name="0.745098_0.737255_0.729412_0.000000_0.000000">
        <color rgba="0.745098 0.737255 0.729412 1" />
      </material>
    </visual>
    <visual>
      <origin xyz="-0.004 0.001521707 0.000143142857" rpy="-1.57079633 -9.74816658e-12 -1.57079898" />
      <geometry>
        <mesh filename="package://amr_description/meshes/Default__Ball_Caster_12mm_stp_1___02_______4_stp_1_solid1.obj" scale="1 1 1" />
      </geometry>
      <material name="0.745098_0.737255_0.729412_0.000000_0.000000">
        <color rgba="0.745098 0.737255 0.729412 1" />
      </material>
    </visual>
    <visual>
      <origin xyz="-0.004 0.001521707 0.000143142857" rpy="-1.57079633 -9.74816658e-12 -1.57079898" />
      <geometry>
        <mesh filename="package://amr_description/meshes/Default__Ball_Caster_12mm_stp_1___02_______4_stp_2_solid1.obj" scale="1 1 1" />
      </geometry>
      <material name="0.745098_0.737255_0.729412_0.000000_0.000000">
        <color rgba="0.745098 0.737255 0.729412 1" />
      </material>
    </visual>
    <visual>
      <origin xyz="-0.004 0.001521707 0.000143142857" rpy="-1.57079633 -9.74816658e-12 -1.57079898" />
      <geometry>
        <mesh filename="package://amr_description/meshes/Default__Ball_Caster_12mm_stp_1___02_______4_stp_3_solid1.obj" scale="1 1 1" />
      </geometry>
      <material name="0.745098_0.737255_0.729412_0.000000_0.000000">
        <color rgba="0.745098 0.737255 0.729412 1" />
      </material>
    </visual>
    <visual>
      <origin xyz="-0.004 0.001521707 0.000143142857" rpy="-1.57079633 -9.74816658e-12 -1.57079898" />
      <geometry>
        <mesh filename="package://amr_description/meshes/Default__Ball_Caster_12mm_stp_1___02_______4_stp_4_solid1.obj" scale="1 1 1" />
      </geometry>
      <material name="0.745098_0.737255_0.729412_0.000000_0.000000">
        <color rgba="0.745098 0.737255 0.729412 1" />
      </material>
    </visual>
    <visual>
      <origin xyz="-0.004 0.001521707 0.000143142857" rpy="-1.57079633 -9.74816658e-12 -1.57079898" />
      <geometry>
        <mesh filename="package://amr_description/meshes/Default__Ball_Caster_12mm_stp_1___03_________stp_1_solid1.obj" scale="1 1 1" />
      </geometry>
      <material name="0.921569_0.921569_0.921569_0.000000_0.000000">
        <color rgba="0.921569 0.921569 0.921569 1" />
      </material>
    </visual>
    <visual>
      <origin xyz="-0.004 0.001521707 0.000143142857" rpy="-1.57079633 -9.74816658e-12 -1.57079898" />
      <geometry>
        <mesh filename="package://amr_description/meshes/Default__Ball_Caster_12mm_stp_1___04________stp_1_solid1.obj" scale="1 1 1" />
      </geometry>
      <material name="0.921569_0.921569_0.921569_0.000000_0.000000">
        <color rgba="0.921569 0.921569 0.921569 1" />
      </material>
    </visual>
  </link>
  <link name="left_caster_link">
    <xacro:sphere_inertial mass="0.05" radius="0.012" />
    <collision>
      <origin xyz="0 0 -0.0045" rpy="0 0 0" />
      <geometry>
        <sphere radius="0.012" />
      </geometry>
    </collision>
    <visual>
      <origin xyz="-0.001 -0.001521707 0.000143142857" rpy="-1.57079633 9.74616658e-12 -1.57079367" />
      <geometry>
        <mesh filename="package://amr_description/meshes/Default__Ball_Caster_12mm_stp_1___01_______12_stp_1_solid1.obj" scale="1 1 1" />
      </geometry>
      <material name="0.745098_0.737255_0.729412_0.000000_0.000000">
        <color rgba="0.745098 0.737255 0.729412 1" />
      </material>
    </visual>
    <visual>
      <origin xyz="-0.001 -0.001521707 0.000143142857" rpy="-1.57079633 9.74616658e-12 -1.57079367" />
      <geometry>
        <mesh filename="package://amr_description/meshes/Default__Ball_Caster_12mm_stp_1___02_______4_stp_1_solid1.obj" scale="1 1 1" />
      </geometry>
      <material name="0.745098_0.737255_0.729412_0.000000_0.000000">
        <color rgba="0.745098 0.737255 0.729412 1" />
      </material>
    </visual>
    <visual>
      <origin xyz="-0.001 -0.001521707 0.000143142857" rpy="-1.57079633 9.74616658e-12 -1.57079367" />
      <geometry>
        <mesh filename="package://amr_description/meshes/Default__Ball_Caster_12mm_stp_1___02_______4_stp_2_solid1.obj" scale="1 1 1" />
      </geometry>
      <material name="0.745098_0.737255_0.729412_0.000000_0.000000">
        <color rgba="0.745098 0.737255 0.729412 1" />
      </material>
    </visual>
    <visual>
      <origin xyz="-0.001 -0.001521707 0.000143142857" rpy="-1.57079633 9.74616658e-12 -1.57079367" />
      <geometry>
        <mesh filename="package://amr_description/meshes/Default__Ball_Caster_12mm_stp_1___02_______4_stp_3_solid1.obj" scale="1 1 1" />
      </geometry>
      <material name="0.745098_0.737255_0.729412_0.000000_0.000000">
        <color rgba="0.745098 0.737255 0.729412 1" />
      </material>
    </visual>
    <visual>
      <origin xyz="-0.001 -0.001521707 0.000143142857" rpy="-1.57079633 9.74616658e-12 -1.57079367" />
      <geometry>
        <mesh filename="package://amr_description/meshes/Default__Ball_Caster_12mm_stp_1___02_______4_stp_4_solid1.obj" scale="1 1 1" />
      </geometry>
      <material name="0.745098_0.737255_0.729412_0.000000_0.000000">
        <color rgba="0.745098 0.737255 0.729412 1" />
      </material>
    </visual>
    <visual>
      <origin xyz="-0.001 -0.001521707 0.000143142857" rpy="-1.57079633 9.74616658e-12 -1.57079367" />
      <geometry>
        <mesh filename="package://amr_description/meshes/Default__Ball_Caster_12mm_stp_1___03_________stp_1_solid1.obj" scale="1 1 1" />
      </geometry>
      <material name="0.921569_0.921569_0.921569_0.000000_0.000000">
        <color rgba="0.921569 0.921569 0.921569 1" />
      </material>
    </visual>
    <visual>
      <origin xyz="-0.001 -0.001521707 0.000143142857" rpy="-1.57079633 9.74616658e-12 -1.57079367" />
      <geometry>
        <mesh filename="package://amr_description/meshes/Default__Ball_Caster_12mm_stp_1___04________stp_1_solid1.obj" scale="1 1 1" />
      </geometry>
      <material name="0.921569_0.921569_0.921569_0.000000_0.000000">
        <color rgba="0.921569 0.921569 0.921569 1" />
      </material>
    </visual>
  </link>
  <link name="antenna_link">
    <collision name="left_antenna_collision">
      <origin xyz="0 0.0336 0.075" rpy="0 0 0" />
      <geometry>
        <cylinder radius="${antenna_collision_radius}" length="${antenna_collision_height}" />
      </geometry>
    </collision>
    <collision name="right_antenna_collision">
      <origin xyz="0 -0.0336 0.075" rpy="0 0 0" />
      <geometry>
        <cylinder radius="${antenna_collision_radius}" length="${antenna_collision_height}" />
      </geometry>
    </collision>
    <visual>
      <origin xyz="-3.45871022e-08 0.0334999853 -0.00400012305" rpy="-1.01960067e-06 -3.67321487e-06 -1.57079531" />
      <geometry>
        <mesh filename="package://amr_description/meshes/WiFi_Antenna_2__Cut_Extrude1.obj" scale="1 1 1" />
      </geometry>
      <material name="0.752941_0.752941_0.752941_0.000000_0.000000">
        <color rgba="0.752941 0.752941 0.752941 1" />
      </material>
    </visual>
    <visual>
      <origin xyz="3.37276991e-08 -0.0335000147 -0.00399987695" rpy="1.01961041e-06 3.67321216e-06 1.5708" />
      <geometry>
        <mesh filename="package://amr_description/meshes/WiFi_Antenna_2__Cut_Extrude1.obj" scale="1 1 1" />
      </geometry>
      <material name="0.752941_0.752941_0.752941_0.000000_0.000000">
        <color rgba="0.752941 0.752941 0.752941 1" />
      </material>
    </visual>
    <visual>
      <origin xyz="5.38880472e-08 0.0335999434 0.0154127234" rpy="1.01961041e-06 3.67321216e-06 1.5708" />
      <geometry>
        <mesh filename="package://amr_description/meshes/WiFi_Antenna__Fillet3.obj" scale="1 1 1" />
      </geometry>
      <material name="0.752941_0.752941_0.752941_0.000000_0.000000">
        <color rgba="0.752941 0.752941 0.752941 1" />
      </material>
    </visual>
    <visual>
      <origin xyz="5.38880472e-08 -0.0335999434 0.0154127234" rpy="1.01961041e-06 3.67321216e-06 1.5708" />
      <geometry>
        <mesh filename="package://amr_description/meshes/WiFi_Antenna__Fillet3.obj" scale="1 1 1" />
      </geometry>
      <material name="0.752941_0.752941_0.752941_0.000000_0.000000">
        <color rgba="0.752941 0.752941 0.752941 1" />
      </material>
    </visual>
  </link>
  <joint name="base_link_to_chassis" type="fixed">
    <origin xyz="0 0 0" rpy="0 -0 0" />
    <parent link="base_link" />
    <child link="chassis_link" />
  </joint>
  <joint name="left_wheel_joint" type="continuous">
    <origin xyz="0 0.0875 0" rpy="0 -0 0" />
    <axis xyz="0 1 0" />
    <dynamics damping="0.1" friction="0.03" />
    <parent link="base_link" />
    <child link="left_wheel_link" />
  </joint>
  <joint name="right_wheel_joint" type="continuous">
    <origin xyz="0 -0.0875 0" rpy="0 -0 0" />
    <axis xyz="0 1 0" />
    <dynamics damping="0.1" friction="0.03" />
    <parent link="base_link" />
    <child link="right_wheel_link" />
  </joint>
  <joint name="base_link_to_right_caster" type="fixed">
    <origin xyz="0.0852169927 -0.000901843 -0.0183911429" rpy="0 -0 0" />
    <parent link="base_link" />
    <child link="right_caster_link" />
  </joint>
  <joint name="base_link_to_left_caster" type="fixed">
    <origin xyz="-0.0397830073 -0.000901843 -0.0183911429" rpy="0 -0 0" />
    <parent link="base_link" />
    <child link="left_caster_link" />
  </joint>
  <joint name="base_link_to_antenna" type="fixed">
    <origin xyz="-0.0282686178 -0.000126309031 0.213981697" rpy="0 -0 0" />
    <parent link="base_link" />
    <child link="antenna_link" />
  </joint>
  </xacro:macro>
</robot>
