AutodriveAI/Autonomous-Mobile-Robot-/diff_drive_stm32controller/MyProject/Core/Src/main.c

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
/* Includes ------------------------------------------------------------------*/
#include "main.h"

/* USER CODE BEGIN Includes */
#include "encoder.h"
#include "motor.h"
#include "robot_control.h"
/* USER CODE END Includes */

TIM_HandleTypeDef htim1;
TIM_HandleTypeDef htim2;
TIM_HandleTypeDef htim3;
TIM_HandleTypeDef htim4;

UART_HandleTypeDef huart2;

void SystemClock_Config(void);
static void MX_GPIO_Init(void);
static void MX_USART2_UART_Init(void);
static void MX_TIM2_Init(void);
static void MX_TIM3_Init(void);
static void MX_TIM1_Init(void);
static void MX_TIM4_Init(void);
/**
  * @brief  The application entry point.
  * @retval int
  */
int main(void)
{

  /* MCU Configuration--------------------------------------------------------*/

  /* Reset of all peripherals, Initializes the Flash interface and the Systick. */
  HAL_Init();

  /* Configure the system clock */
  SystemClock_Config();

  /* Initialize all configured peripherals */
  MX_GPIO_Init();
  MX_USART2_UART_Init();
  MX_TIM2_Init();
  MX_TIM3_Init();
  MX_TIM1_Init();
  MX_TIM4_Init();
  /* USER CODE BEGIN 2 */
  /* TIM2 drives left; TIM3 drives right.  Channel 2 is forward by wiring test. */
  Motor_Init(&htim2, TIM_CHANNEL_2, TIM_CHANNEL_1,
      &htim3, TIM_CHANNEL_2, TIM_CHANNEL_1);
  Encoder_Init(&htim4, &htim1);
  RobotControl_Init(&huart2);

  /* USER CODE END 2 */

  /* Infinite loop */
  /* USER CODE BEGIN WHILE */
  while (1)
  {
    /* USER CODE END WHILE */

    /* USER CODE BEGIN 3 */
    /* Poll PB6/PA8 as debounced digital encoder inputs. */
    Encoder_Update();

    /* Poll serial input, run motor/PID safety logic, and send encoder telemetry. */
    RobotControl_Update();
  }
  /* USER CODE END 3 */
}

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
/* USER CODE BEGIN 4 */

/* Application-specific logic lives in motor.c, encoder.c, wheel_pid.c,
 * and robot_control.c.  Keep this CubeMX user block empty. */

/* Application-specific logic is implemented in the dedicated Core modules. */

/* USER CODE END 4 */
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
