AutodriveAI/Autonomous-Mobile-Robot-/ros2_ws/src/amr_slam/config/mapper_params_online_sync.yaml

slam_toolbox:
  ros__parameters:
    # Solver plugin used internally by Slam Toolbox to optimize the pose graph.
    solver_plugin: solver_plugins::CeresSolver
    ceres_linear_solver: SPARSE_NORMAL_CHOLESKY
    ceres_preconditioner: SCHUR_JACOBI
    ceres_trust_strategy: LEVENBERG_MARQUARDT
    ceres_dogleg_type: TRADITIONAL_DOGLEG
    ceres_loss_function: None

    # Frame setup for our robot:
    #   map -> odom       published by slam_toolbox
    #   odom -> base_link published by amr_driver wheel odometry
    #   base_link -> lidar_link -> lidar_scan_link published by robot_state_publisher from URDF
    odom_frame: odom
    map_frame: map
    base_frame: base_link
    scan_topic: /scan

    # We are using this package for mapping, not localization against a saved map.
    mode: mapping
    use_map_saver: true
    enable_interactive_mode: true

    # Real robot default. For Gazebo mapping, launch with use_sim_time:=true.
    use_sim_time: false

    # Mapping behavior. These are conservative defaults for a slow indoor AMR.
    debug_logging: false
    throttle_scans: 1
    transform_publish_period: 0.02
    map_update_interval: 2.0
    # Occupancy-grid map resolution in meters/cell.
    # Smaller value = sharper map, but more memory/CPU and more sensitivity to
    # LiDAR noise. 0.03 means each map pixel represents 3 cm in the real world.
    resolution: 0.03
    min_laser_range: 0.15
    max_laser_range: 12.0
    minimum_time_interval: 0.2
    transform_timeout: 0.2
    tf_buffer_duration: 30.0
    stack_size_to_use: 40000000

    # Scan matching and loop closure.
    use_scan_matching: true
    use_scan_barycenter: true
    minimum_travel_distance: 0.10
    minimum_travel_heading: 0.10
    scan_buffer_size: 10
    scan_buffer_maximum_scan_distance: 10.0
    link_match_minimum_response_fine: 0.1
    link_scan_maximum_distance: 1.5
    loop_search_maximum_distance: 3.0
    do_loop_closing: true
    loop_match_minimum_chain_size: 10
    loop_match_maximum_variance_coarse: 3.0
    loop_match_minimum_response_coarse: 0.35
    loop_match_minimum_response_fine: 0.45

    # Correlation search windows.
    correlation_search_space_dimension: 0.5
    correlation_search_space_resolution: 0.01
    correlation_search_space_smear_deviation: 0.1
    loop_search_space_dimension: 8.0
    loop_search_space_resolution: 0.05
    loop_search_space_smear_deviation: 0.03

    # Scan matcher penalties.
    distance_variance_penalty: 0.5
    angle_variance_penalty: 1.0
    fine_search_angle_offset: 0.00349
    coarse_search_angle_offset: 0.349
    coarse_angle_resolution: 0.0349
    minimum_angle_penalty: 0.9
    minimum_distance_penalty: 0.5
    use_response_expansion: true
    min_pass_through: 2
    occupancy_threshold: 0.1
