AutodriveAI/Autonomous-Mobile-Robot-/(commit log)

2026-07-25 Added microcontroller firmware
    [65mmPillar.STL]
2026-07-25 Added Motor_Bridge
    [motor_bridge.yaml]
2026-07-25 Changed the folder struct of ros2_ws
    [motor_bridge.yaml]
2026-07-26 Add ROS 2 AMR driver, teleop, and robot description
    [Default__12_STEP_1_Part22_STEP_1_solid1.stl, Default__12_STEP_1_RP_lidar_A1_igs_STEP_1_Woodscrews_GB_TYPE136_M2X6_N_igs_STEP_1_solid1.stl, Default__12_STEP_1_RP_lidar_A1_igs_STEP_1_Woodscrews_GB_TYPE136_M2X6_N_igs_STEP_2_solid1.stl, Default__12_STEP_1_RP_lidar_A1_igs_STEP_1_Woodscrews_GB_TYPE136_M2X6_N_igs_STEP_3_solid1.stl, Default__12_STEP_1_RP_lidar_A1_igs_STEP_1_Woodscrews_GB_TYPE136_M2X6_N_i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]
2026-07-27 Add simplified AMR description and ROS driver updates
    [Default__12_STEP_1_Part22_STEP_1_solid1.obj, Default__12_STEP_1_Part22_STEP_1_solid1.stl, Default__12_STEP_1_RP_lidar_A1_igs_STEP_1_Woodscrews_GB_TYPE136_M2X6_N_igs_STEP_1_solid1.obj, Default__12_STEP_1_RP_lidar_A1_igs_STEP_1_Woodscrews_GB_TYPE136_M2X6_N_igs_STEP_1_solid1.stl, Default__12_STEP_1_RP_lidar_A1_igs_STEP_1_Woodscrews_GB_TYPE136_M2X6_N_igs_STEP_2_solid1.obj, Default__12_STEP_1_RP_lidar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]
2026-07-28 Tune AMR Gazebo description and simulation
    [robot.urdf.xacro, robot_sim.urdf.xacro]
2026-07-29 Wire lidar into AMR bringup
    [Default__12_STEP_1_Part22_STEP_1_solid1.obj, Default__12_STEP_1_Part22_STEP_1_solid1.stl, Default__12_STEP_1_RP_lidar_A1_igs_STEP_1_Woodscrews_GB_TYPE136_M2X6_N_igs_STEP_1_solid1.obj, Default__12_STEP_1_RP_lidar_A1_igs_STEP_1_Woodscrews_GB_TYPE136_M2X6_N_igs_STEP_1_solid1.stl, Default__12_STEP_1_RP_lidar_A1_igs_STEP_1_Woodscrews_GB_TYPE136_M2X6_N_igs_STEP_2_solid1.obj, Default__12_STEP_1_RP_lidar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]
2026-07-31 Checkpoint odometry and lidar scan frame updates
    [gazebo.xacro, lidar.xacro]
2026-07-31 Switch active lidar configuration to RPLIDAR C1
    [gazebo.xacro, lidar.xacro]
2026-08-02 Tune real robot navigation bringup
    [65mmPillar.STL, Hex Spacer.step, STM32 Nucleo'.step, WiFi Antenna.STEP, antenna mount.stl, gazebo.xacro, robot_core.xacro]
2026-10-15 Add operator GUI and real robot support
    [GamePadDongleHolder.stl]
