AutodriveAI/Autonomous-Mobile-Robot-/(notices)

Notices in the files:
diff_drive_stm32controller/MyProject/Core/Src/main.c:
Copyright (c) 2026 STMicroelectronics.
All rights reserved.
This software is licensed under terms that can be found in the LICENSE file
